cherryphilip74/ArdPressure_filler/V1_dietro.jpeg

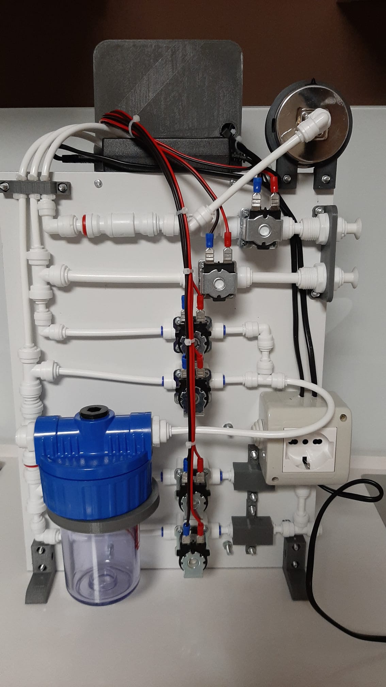
V1_dietro.jpeg
