cherryphilip74/ArdPressure_filler/V3_fronte.jpeg

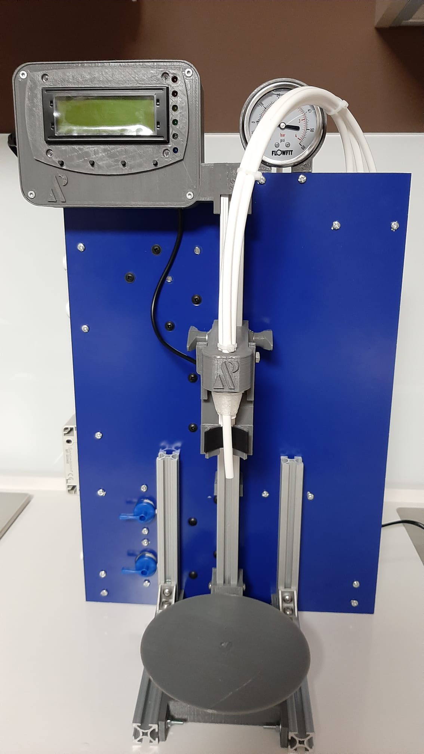
V3_fronte.jpeg
