cherryphilip74/ArdPressure_filler/README.md

# ArdPressure_filler
Counter bottle pressure filler tool
