cherryphilip74/ArdPressure_filler/ARDPressure_V1_Filler.png

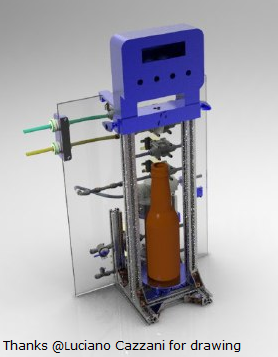
ARDPressure_V1_Filler.png
