cherryphilip74/ArdPressure_filler/ARDPressure_V1_Filler_rear.jpeg

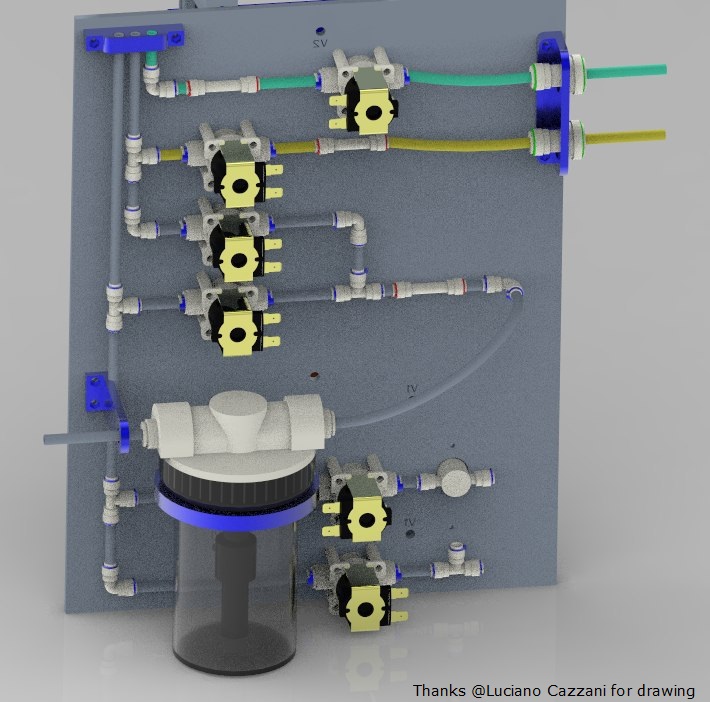
ARDPressure_V1_Filler_rear.jpeg
