cherryphilip74/ArdPressure_filler/Solenoid_Valve_pannel.png

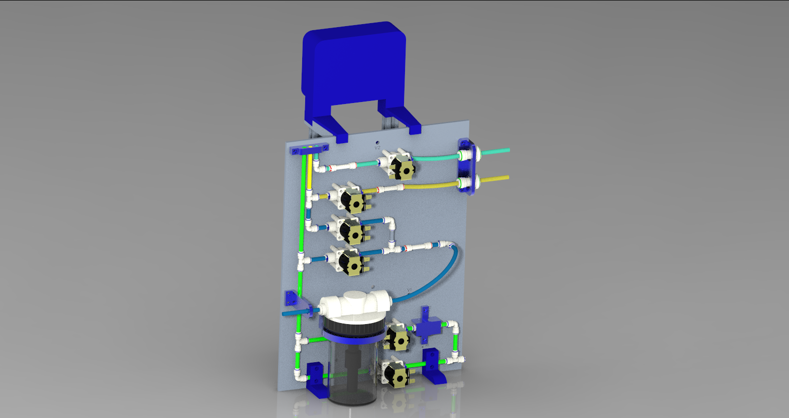
Solenoid_Valve_pannel.png
