cherryphilip74/ArdPressure_filler/V1_fronte.jpeg

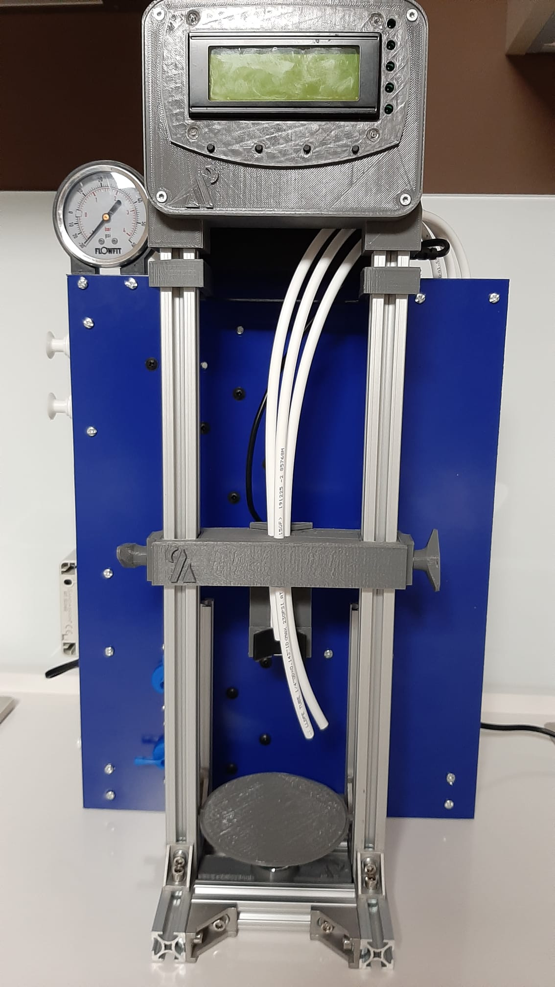
V1_fronte.jpeg
