cherryphilip74/ArdPressure_filler/V3_dietro.jpeg

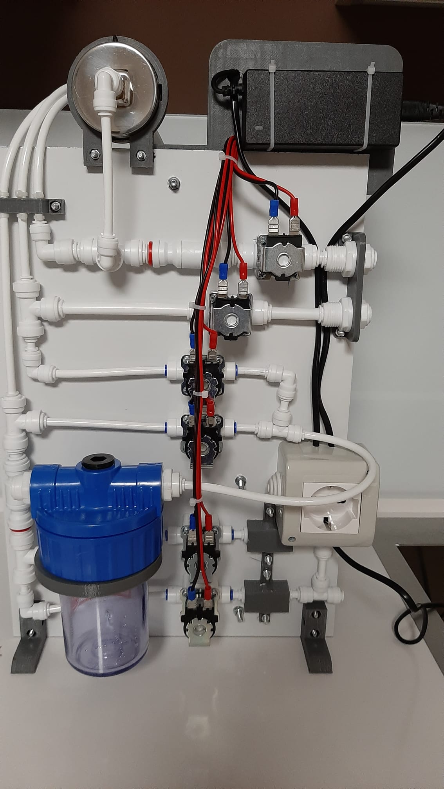
V3_dietro.jpeg
