cherryphilip74/ArdPressure_filler/LEG_EV_PANNEL_SUPPORT_V1.stl

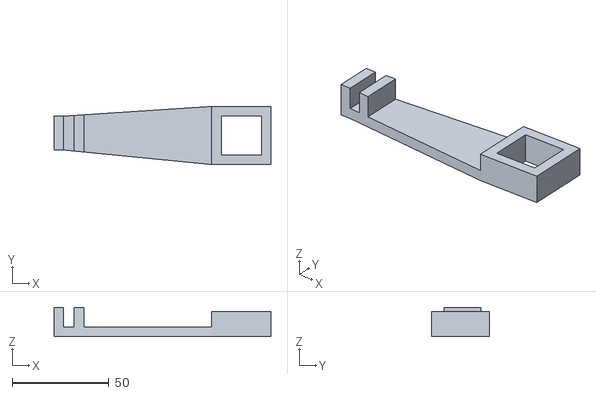
[picture p9: CAD file, 2020-04-16, last stored version]
LEG_EV_PANNEL_SUPPORT_V1.stl
112.0 x 30.0 x 15.0
