cherryphilip74/ArdPressure_filler/M5_BUTTERFLY_V1.stl

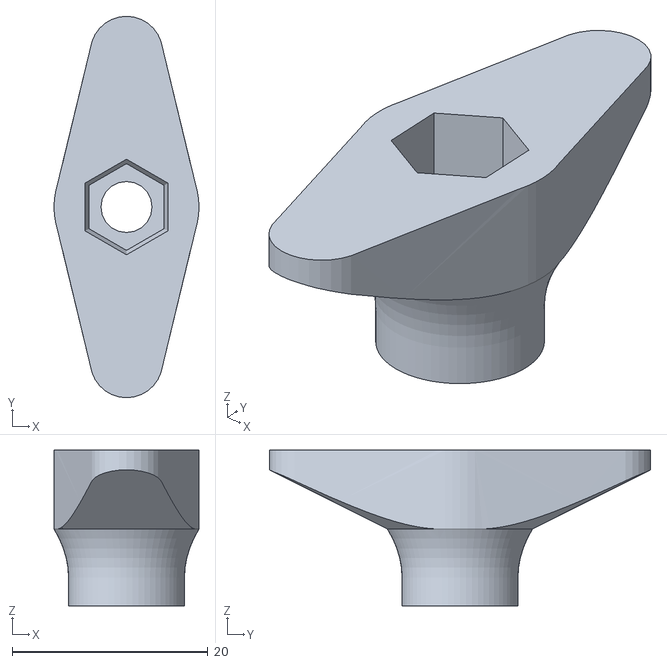
[picture p10: CAD file, 2020-04-16, last stored version]
M5_BUTTERFLY_V1.stl
14.8 x 39.0 x 15.9
