cherryphilip74/ArdPressure_filler/BOTTLE_BASE_V1.stl

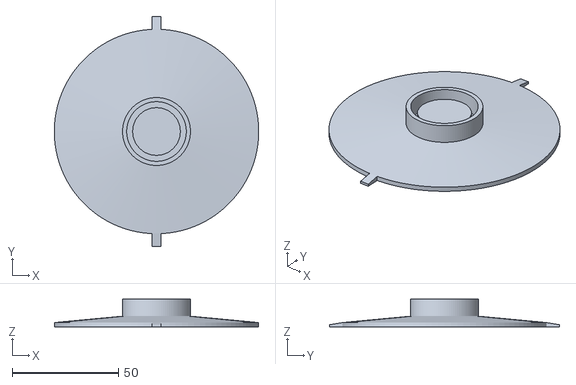
[picture p11: CAD file, 2020-04-16, last stored version]
BOTTLE_BASE_V1.stl
96.0 x 108.0 x 13.0
