cherryphilip74/ArdPressure_filler/SPRING_SUPPORT_V1.stl

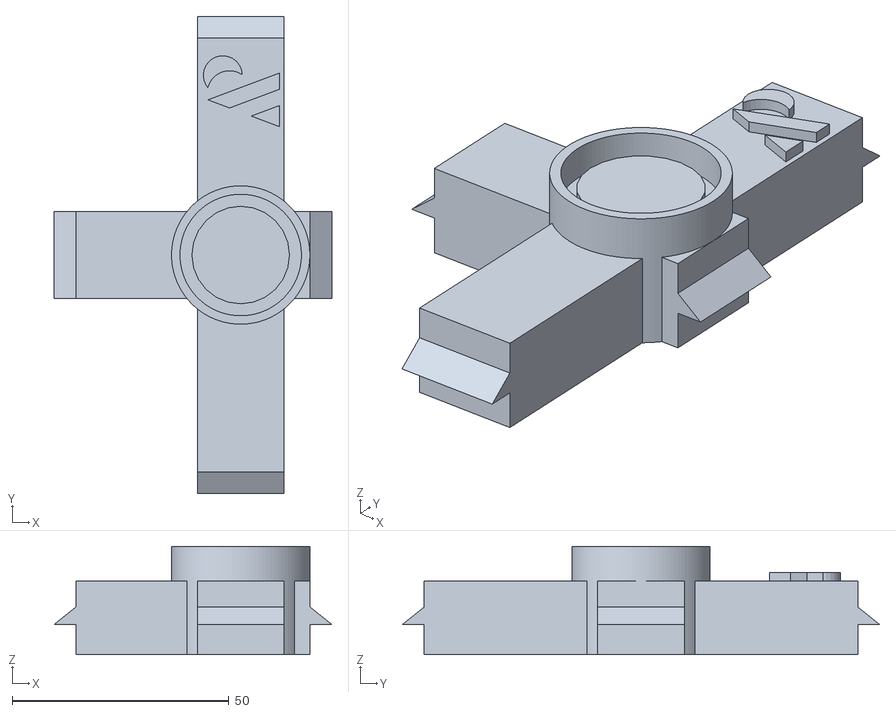
[picture p12: CAD file, 2020-04-16, last stored version]
SPRING_SUPPORT_V1.stl
64.0 x 110.0 x 25.0
