cherryphilip74/ArdPressure_filler/BULKHEAD_SUPPORT_V1.stl

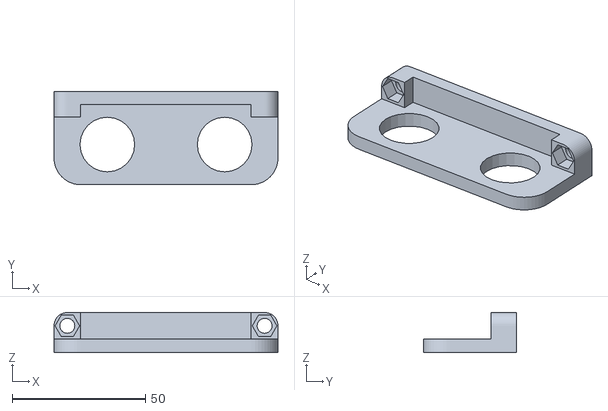
[picture p13: CAD file, 2020-04-16, last stored version]
BULKHEAD_SUPPORT_V1.stl
84.0 x 35.0 x 15.0
