cherryphilip74/ArdPressure_filler/TAP_COVER_V1.stl

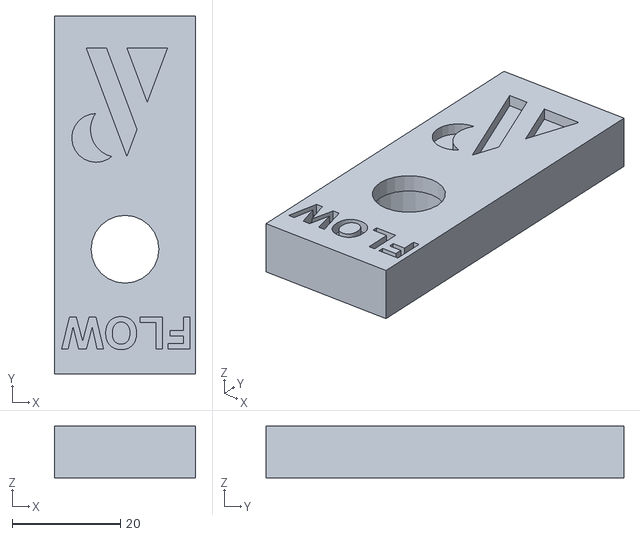
[picture p14: CAD file, 2020-04-16, last stored version]
TAP_COVER_V1.stl
26.0 x 66.0 x 9.50
