cherryphilip74/ArdPressure_filler/HEAD_3_HOLES.stl

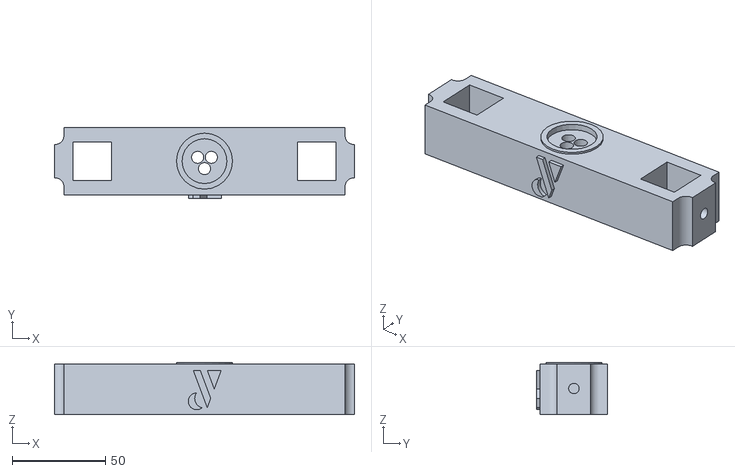
[picture p15: CAD file, 2020-04-16, last stored version]
HEAD_3_HOLES.stl
160.6 x 38.0 x 28.0
