cherryphilip74/ArdPressure_filler/LEVEL_SENSOR_SUPPORT_V1.stl

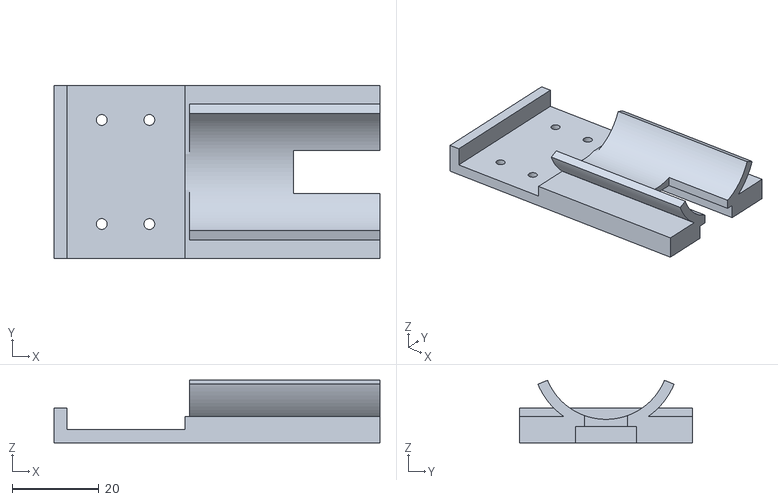
[picture p16: CAD file, 2020-04-16, last stored version]
LEVEL_SENSOR_SUPPORT_V1.stl
75.2 x 40.0 x 14.4
