cherryphilip74/ArdPressure_filler/3_HOLES_HOUSE_V1.stl

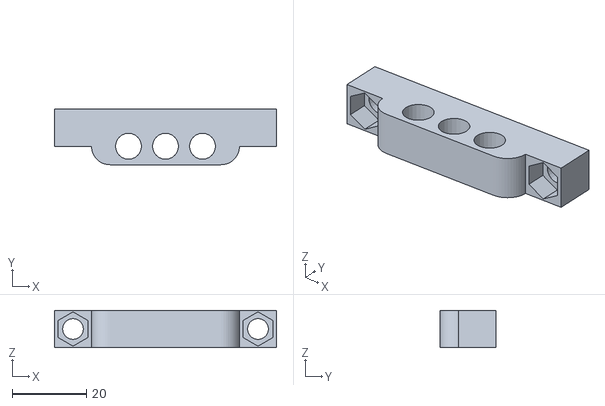
[picture p17: CAD file, 2020-04-16, last stored version]
3_HOLES_HOUSE_V1.stl
60.0 x 15.0 x 10.0
