cherryphilip74/ArdPressure_filler/SUPPORTO_VAC.stl

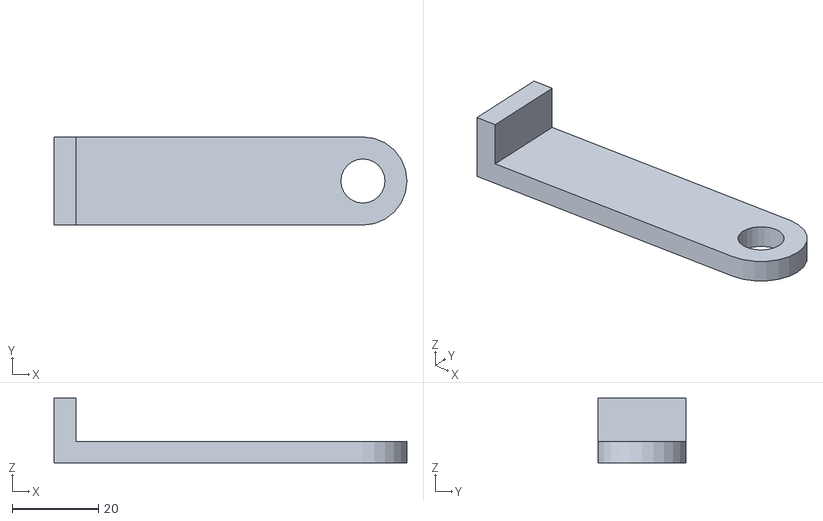
[picture p18: CAD file, 2020-04-16, last stored version]
SUPPORTO_VAC.stl
81.9 x 20.5 x 15.0
