cherryphilip74/ArdPressure_filler/CASE_V1.stl

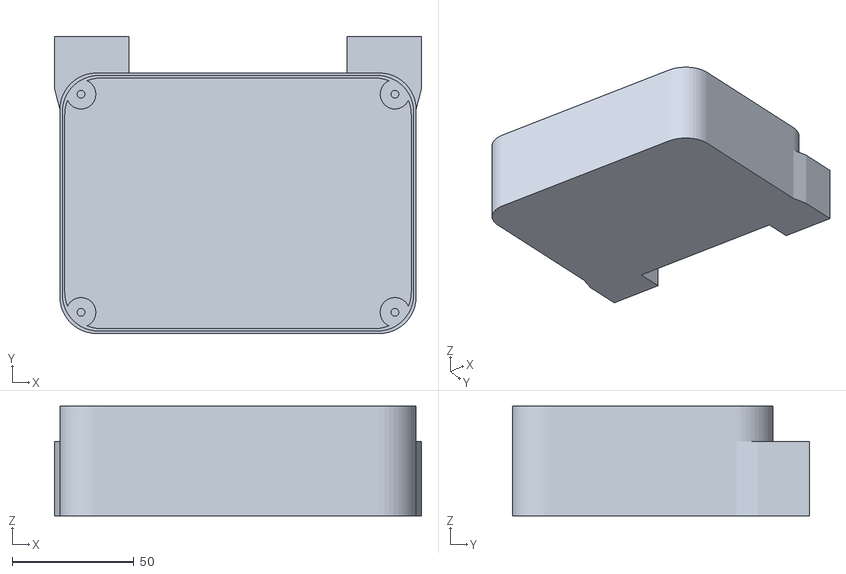
[picture p19: CAD file, 2020-04-16, last stored version]
CASE_V1.stl
150.6 x 121.9 x 45.0
