cherryphilip74/ArdPressure_filler/TANK_SUPPORT.stl

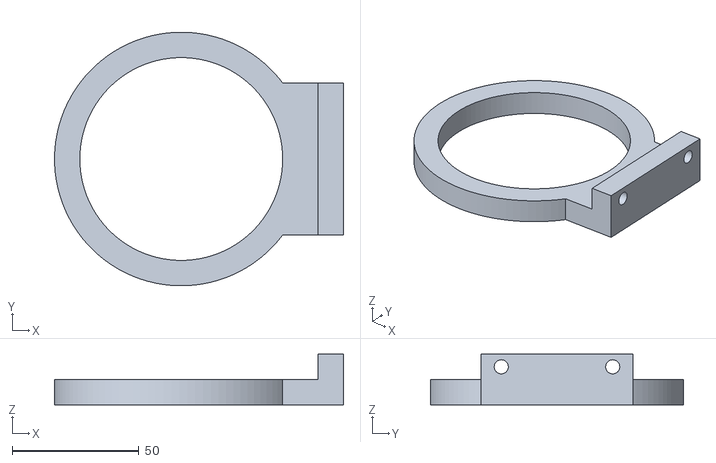
[picture p20: CAD file, 2020-04-16, last stored version]
TANK_SUPPORT.stl
114.0 x 100.0 x 20.0
