cherryphilip74/ArdPressure_filler/(list of files, cad)

Other CAD files:
holes_CNC.dwg
