cherryphilip74/ArdPressure_filler/ASSEMBLY FOR METAL FRAME ARDPRESSURE FILLER KIT.pdf

### ARD PRESSURE (ASSEMBLY MANUAL V1 MODEL)

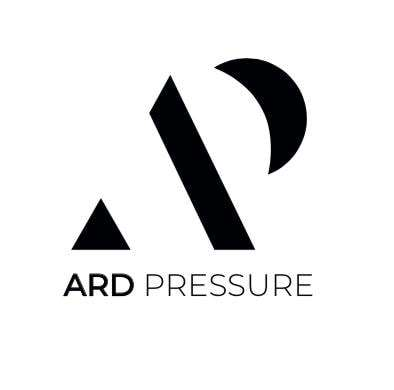
[picture p21: figure]

# ASSEMBLY FOR METAL FRAME ARDPRESSURE FILLER KIT

TABLE OF CONTENTS

### 1. Assembly of the lower chassis 2. Assembly the vertical structure 3. Install the head filler 4. Assembly the solenoide’s pannel 5. Install the solenoide valves 6. Install pipe net 7. Install the case 8. Assemble the ArdPressure and wire connections 9. Fixed power supply

ArdPressure filler, ArdPressure firmware and ArdPressure logo …….

When you use the filler, meet some problems, please contact us.

Technical support telegram ArdPressure:

Please visit the Facebook group, link as follow:

https://www.facebook.com/ArdPressure/

The assembly video as follow:

(video……)

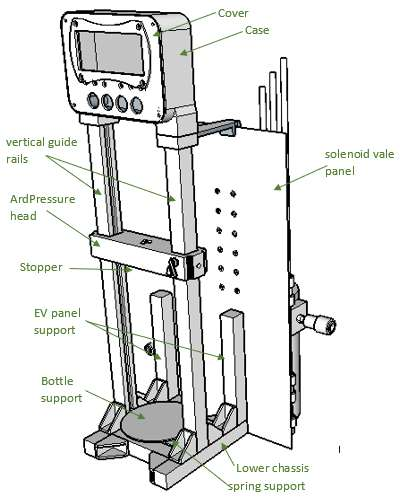
[picture p22: figure]

IN ORDER TO ASSEMBLE, IT’s more convenient to take out the required parts, we have defined each packing slot

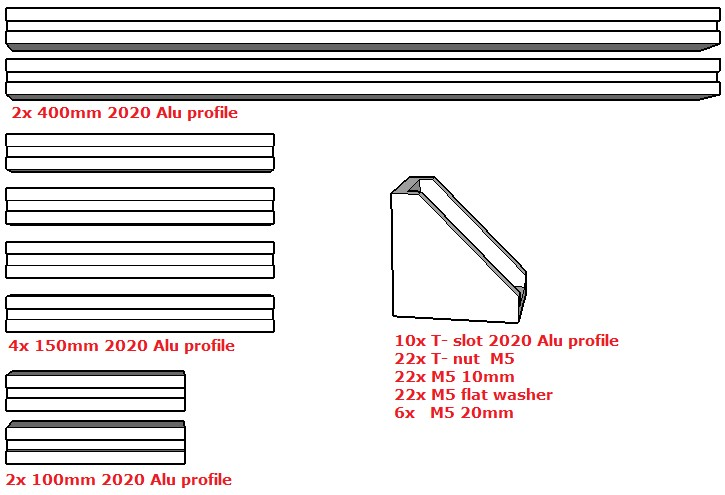
[picture p23: figure]
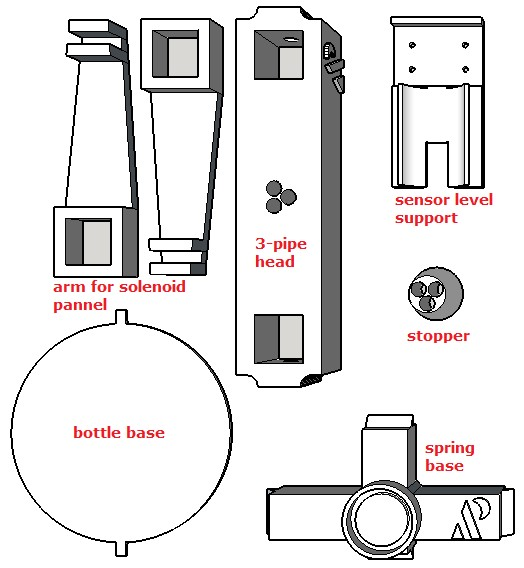
[picture p24: figure]
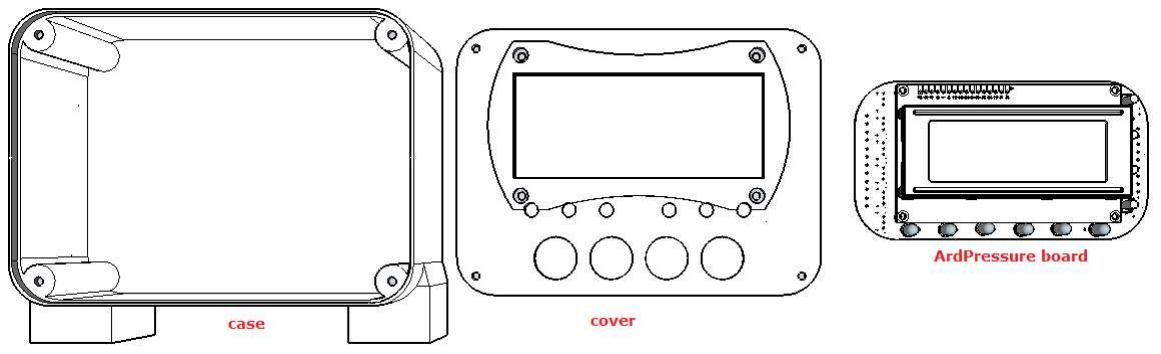
[picture p25: figure]

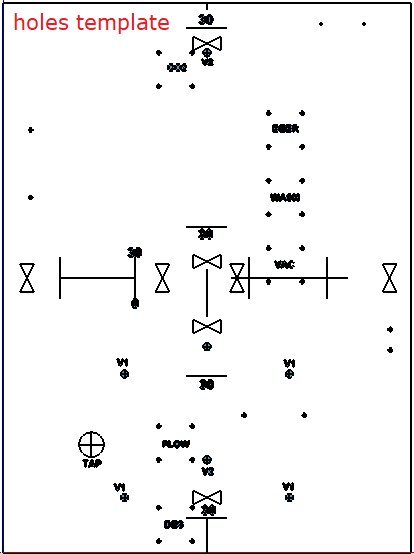
[picture p26: figure]

Other parts:

1x power supply (12v or 24V)

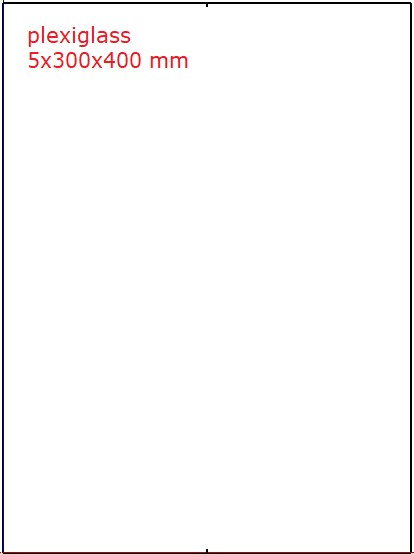
[picture p27: figure]

6x solenoid valve OD ¼ for reverse osmosis water systems (12v or 24v)

6X Elbow Pipe Fittings od ¼ for reverse osmosis water systems

5x Tee Pipe Coupling Connector OD ¼ for reverse osmosis water systems

1x Water Flow Control Valve OD ¼ for reverse osmosis water systems

3x check valve OD ¼ for reverse osmosis water systems

2x Straight Bulkhead Connector OD ¼ internal and OD 3/8 external for reverse osmosis water system

1x Straight Connector 1/2 male Thread OD 1/4 for Plastic Pipe for reverse osmosis water system

1x Straight Connector 1/2 male Thread OD 3/8 for Plastic Pipe for reverse osmosis water system

1x Non-Contact Liquid Level Sensor XKC-Y26-NPN type

1x ssr 10 ampere

LET’S GO……

## 1. Assembly of the lower chassis

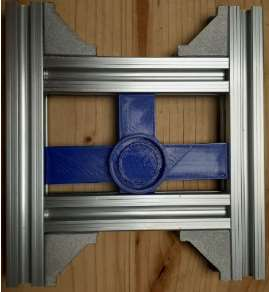
[picture p28: figure]

This is the structure that we will assemble

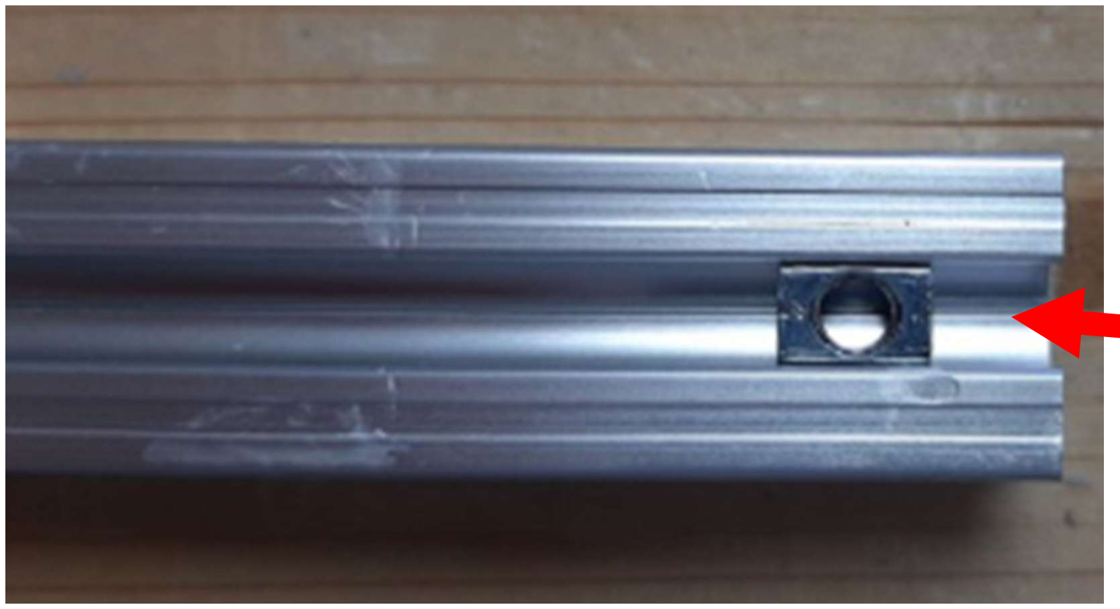
[picture p29: figure]

### INSERT M5 T-NUT

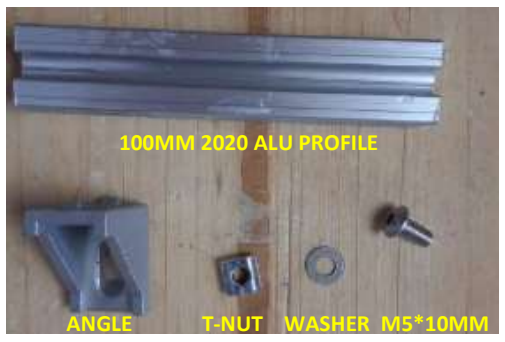
[picture p30: figure]
100MM 2020 ALU PROFILE; ANGLE; T-NUT WASHER M5*10MM
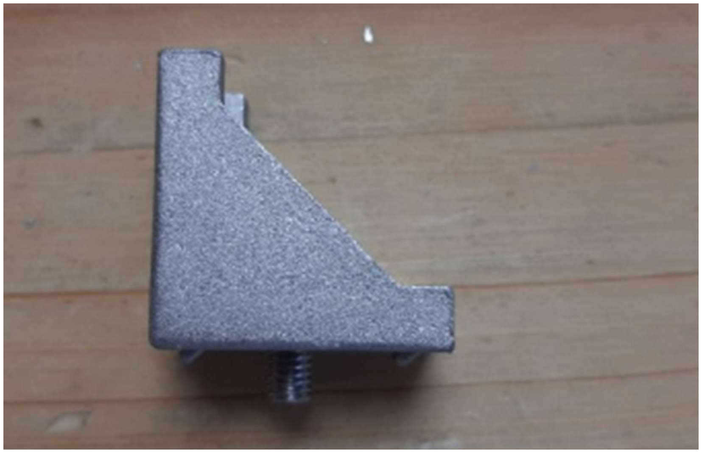
[picture p31: figure]
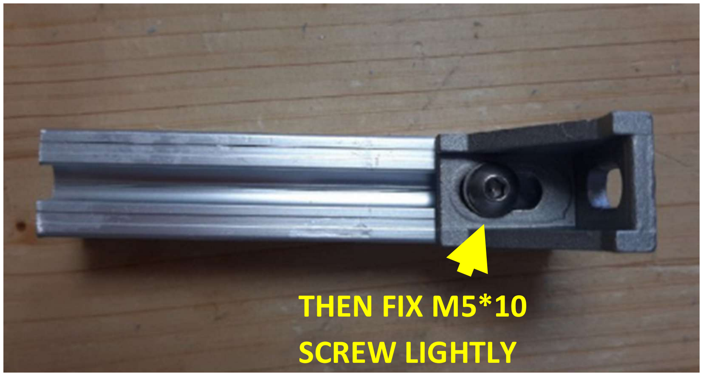
[picture p32: figure]
THEN FIX M5*10 SCREW LIGHTLY

Do the same for the second side

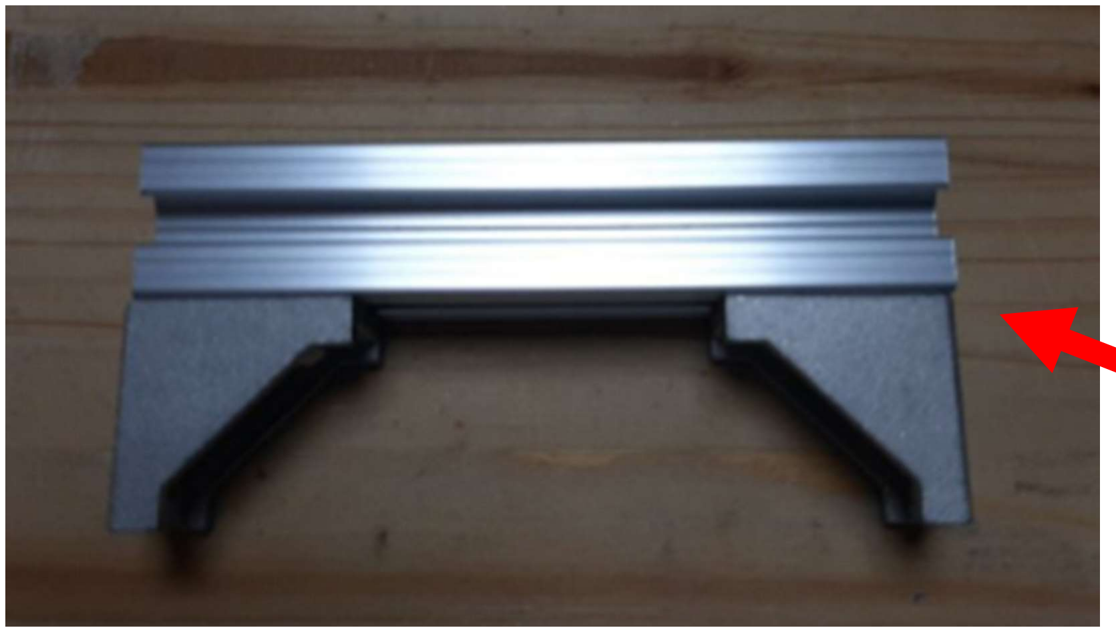
[picture p33: figure]

Repeat for second 100MM arm

### KEEP ALIGN

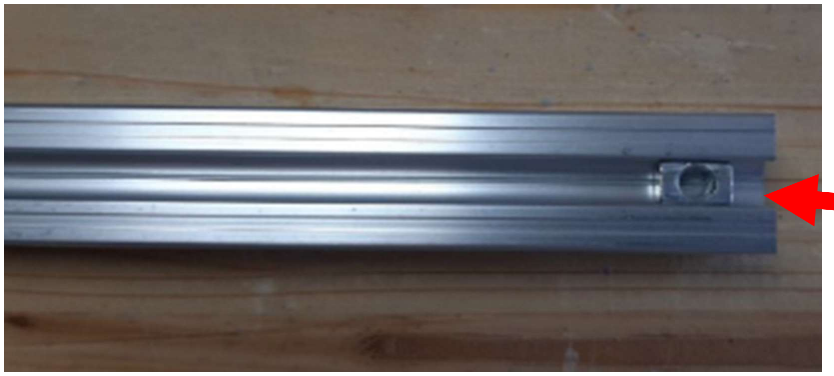
[picture p34: figure]

### INSERT M5 T-NUT

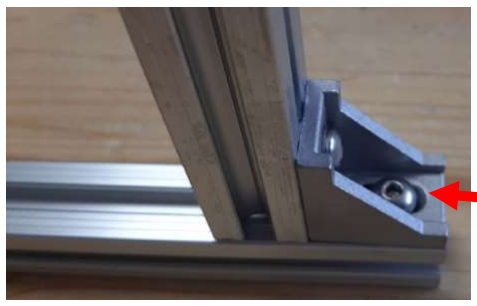
[picture p35: figure]

### PUSH AND KEEP ALIGN

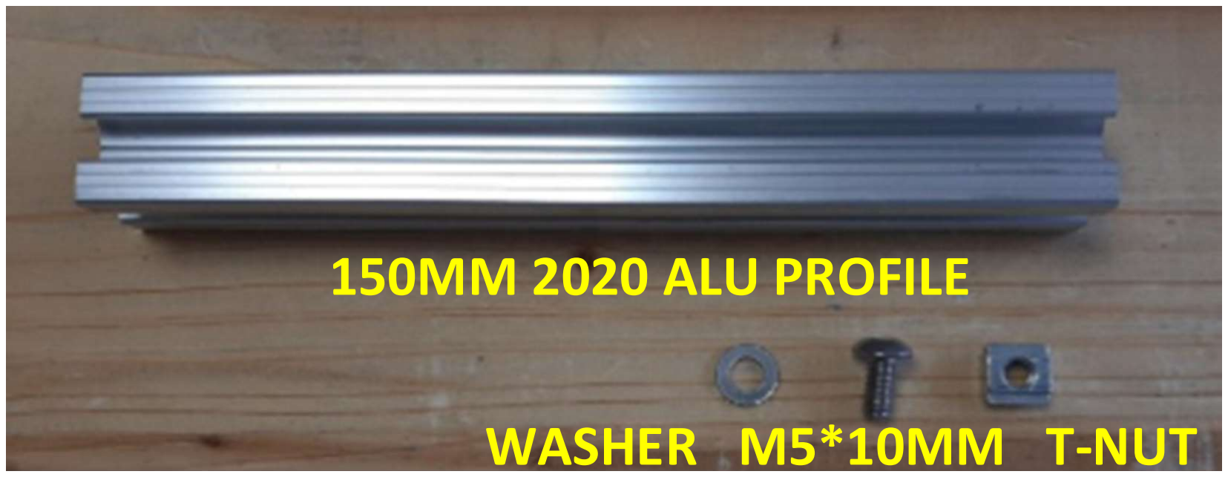
[picture p36: figure]
150MM 2020 ALU PROFILE; WASHER M5*10MM T-NUT
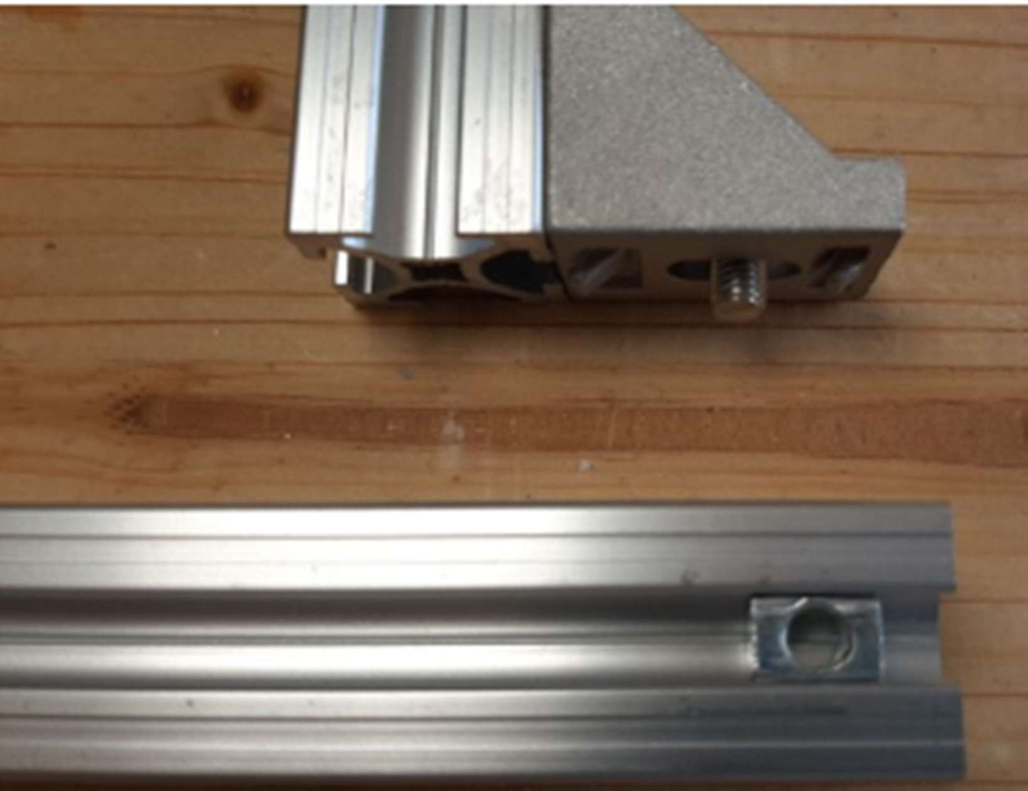
[picture p37: figure]

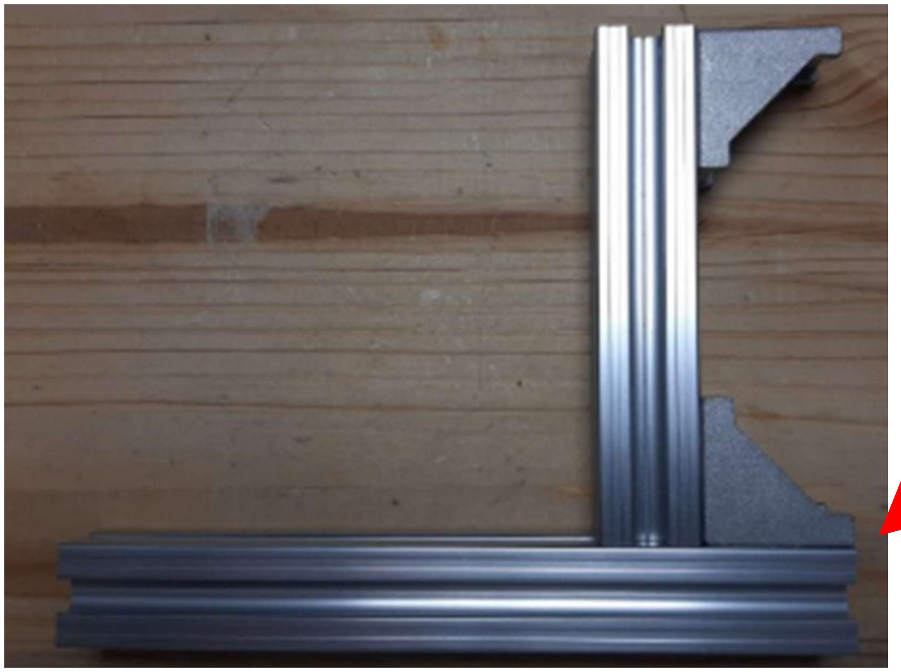
[picture p38: figure]

INSTALL THE OTHER SAME PART IN THE SAME WAY

### KEEP ALIGN

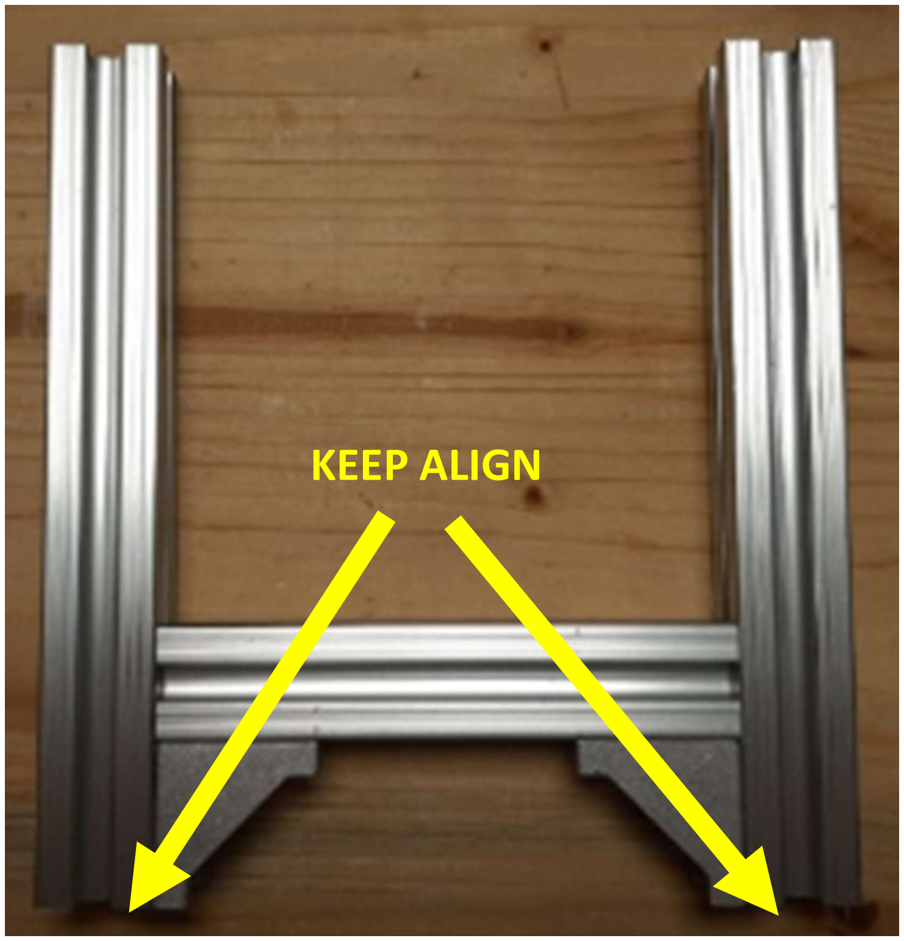
[picture p39: figure]
KEEP ALIGN
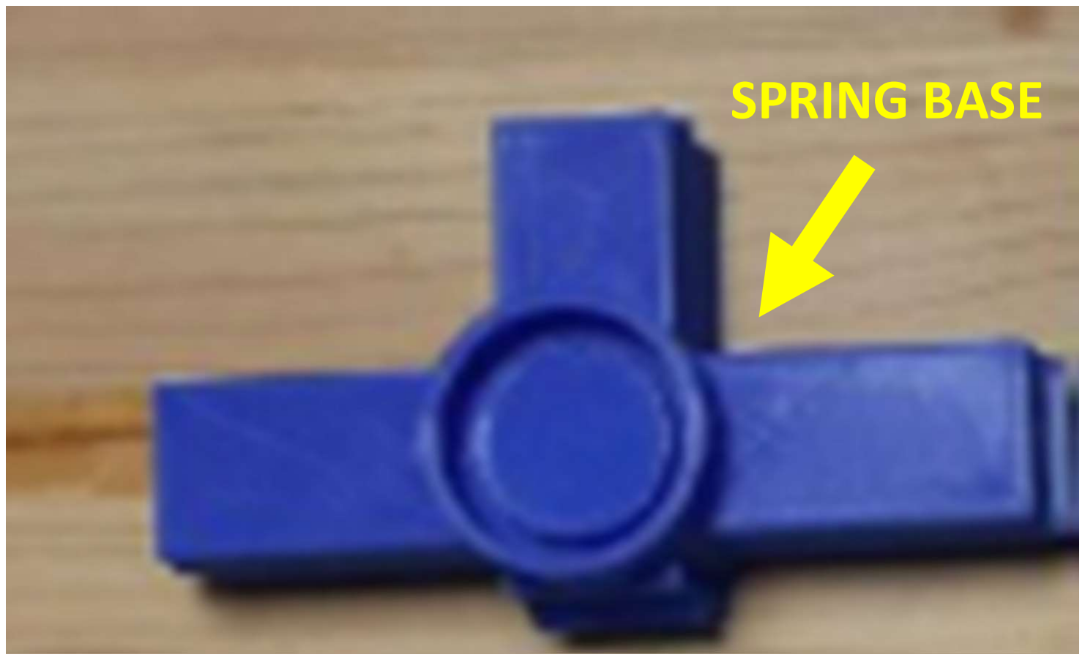
[picture p40: figure]
SPRING BASE

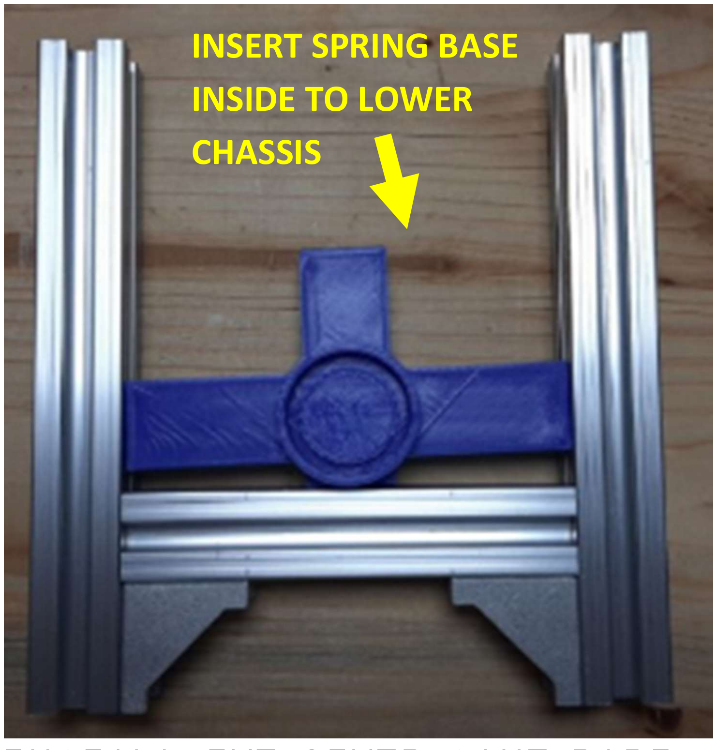
[picture p41: figure]
INSERT SPRING BASE INSIDE TO LOWER CHASSIS

INSTALL THE OTHER SAME PART 100MM ARM IN THE SAME WAY

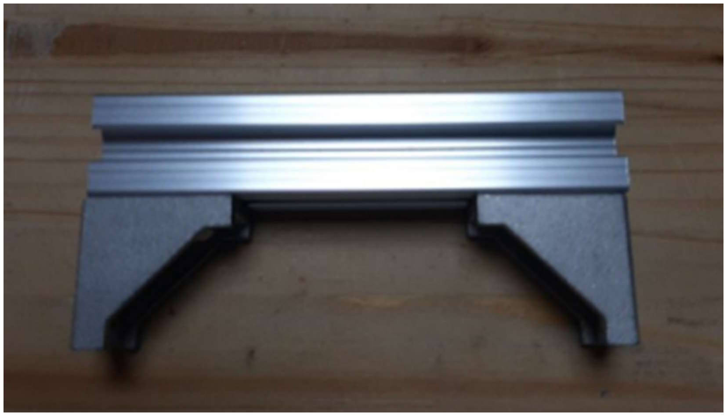
[picture p42: figure]

## 2. Assembly the vertical structure

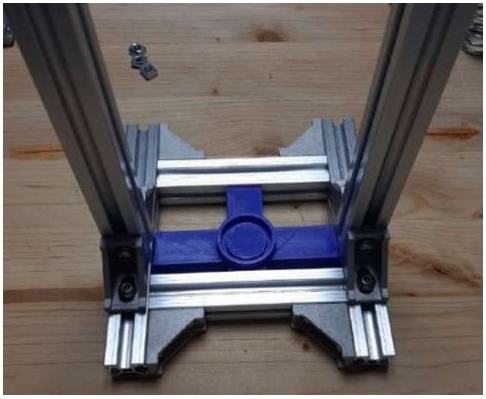
[picture p43: figure]

This is the structure that we will assemble

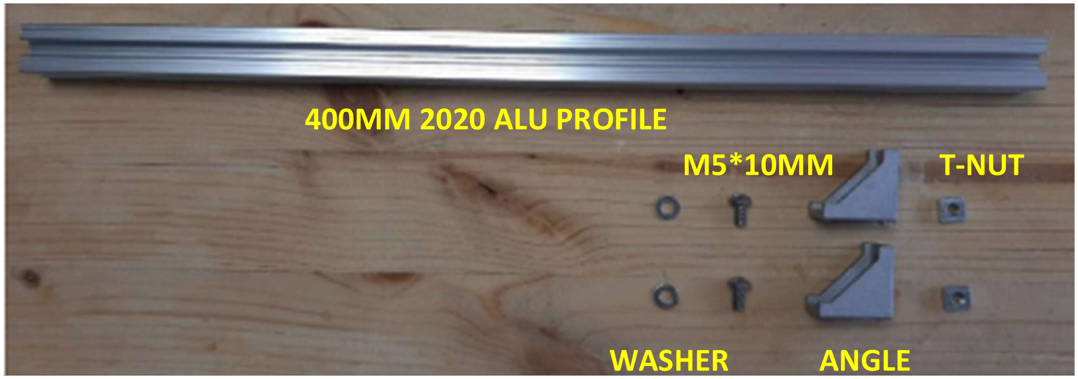
[picture p44: figure]
400MM 2020 ALU PROFILE; T-NUT; WASHER; ANGLE

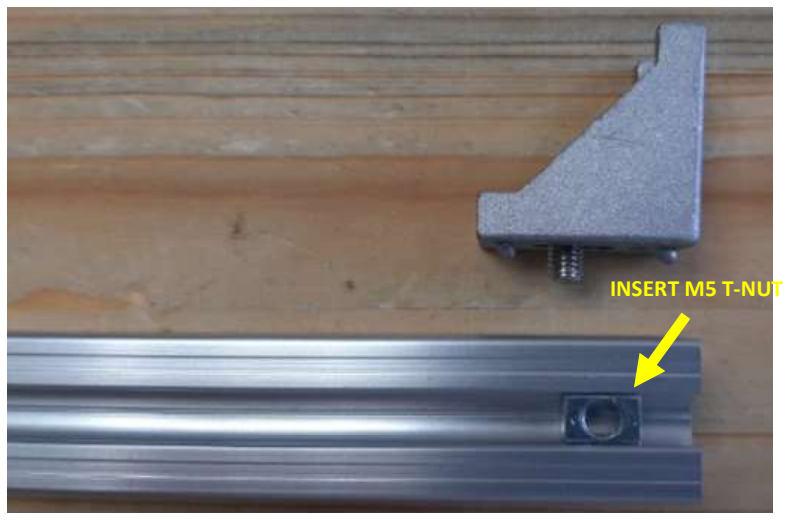
[picture p45: figure]
INSERT M5 T-NUT

INSTAL THE second support angle behind the first

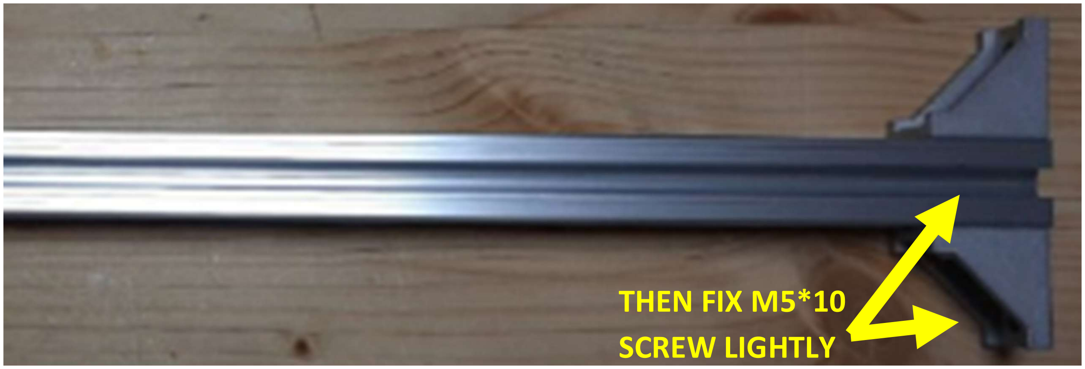
[picture p46: figure]
THEN FIX M5*10 SCREW LIGHTLY

Assemble the same part (400mm alu profile)IN THE SAME WAY

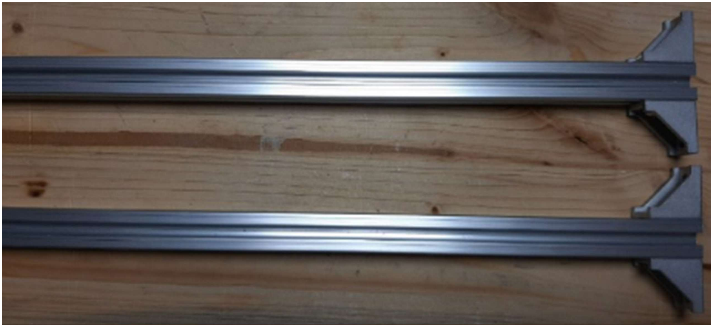
[picture p47: figure]

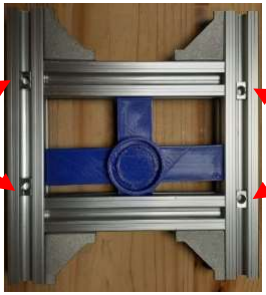
[picture p48: figure]
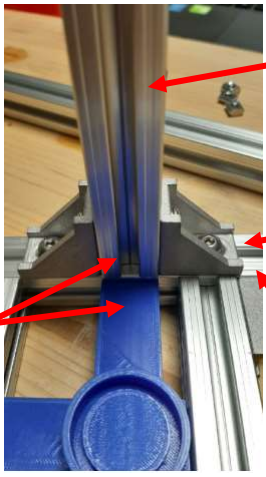
[picture p49: figure]

Assemble the same part (400mm alu profile)IN THE SAME WAY

### INSERT M5 T-NUT

### INSERT M5 T-NUT

### 400MM ALU PROFILE

### 150MM ALU PROFILE

### PUSH AND KEEP ALIGN

### KEEP ALIGN

## 3. Install the head fillER, SPRING AND BOTTLE BASE

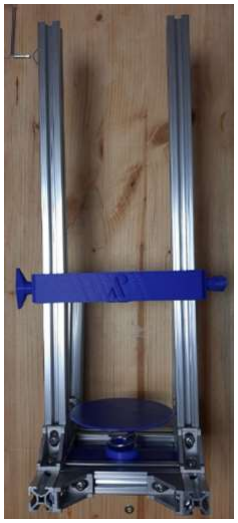
[picture p50: figure]

This is the structure that we will assemble

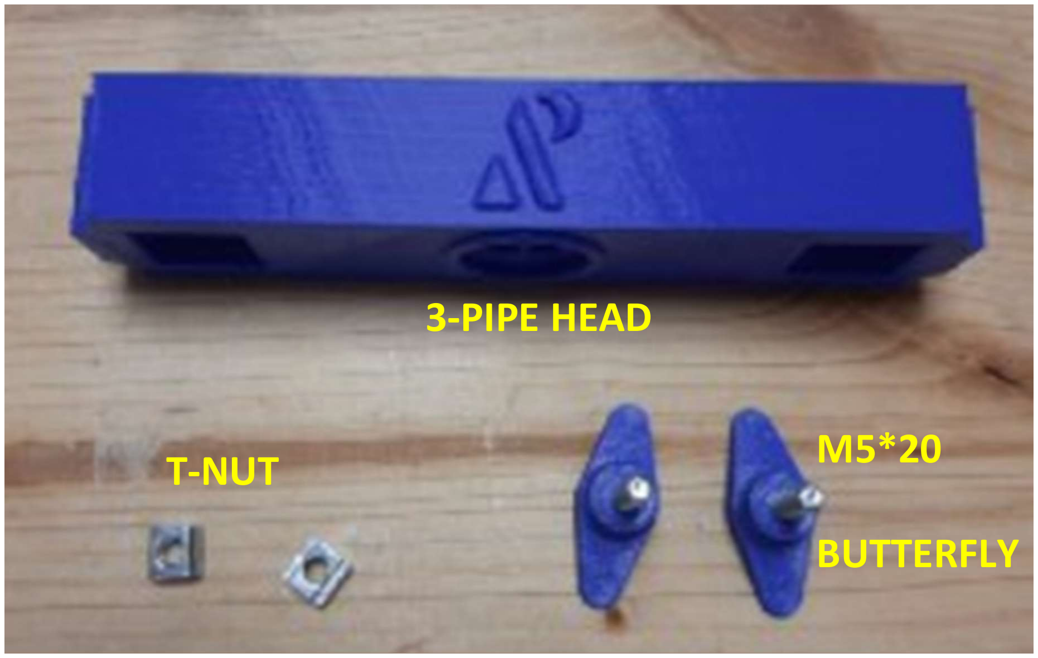
[picture p51: figure]
3-PIPE HEAD; T-NUT; BUTTERFLY
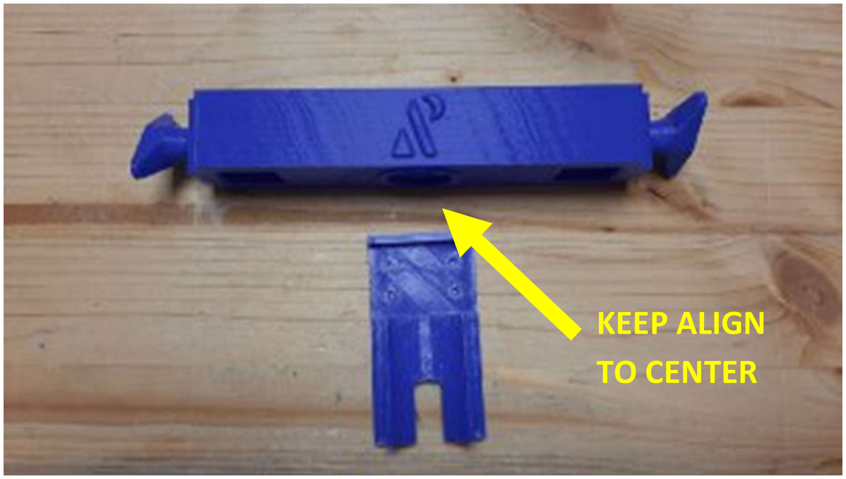
[picture p52: figure]
KEEP ALIGN TO CENTER

INSTALL LEVEL SENSOR SUPPORT

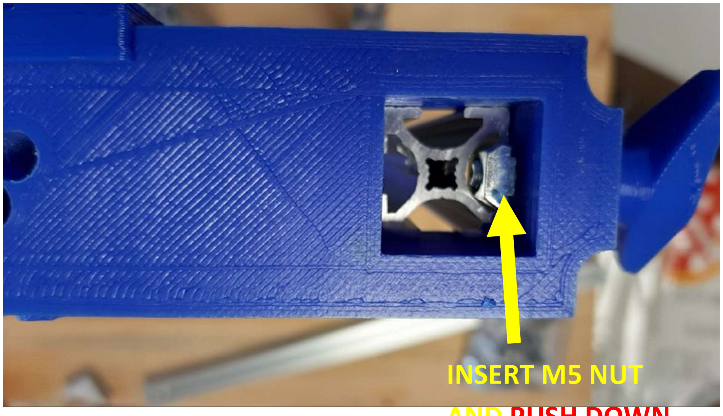
[picture p53: figure]
INSERT M5 NUT
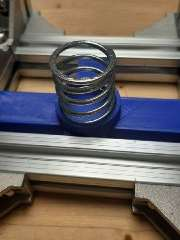
[picture p54: figure]
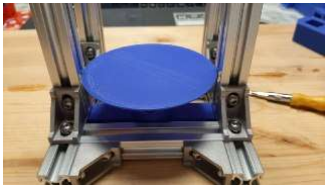
[picture p55: figure]

MOUNT SPRING ON CENTER HOLE AND PUSH DOWN STRONGLY AND THEN PUT THE BOTTLE BASE

### AND PUSH DOWN

## 4. Assembly the solenoid pannel

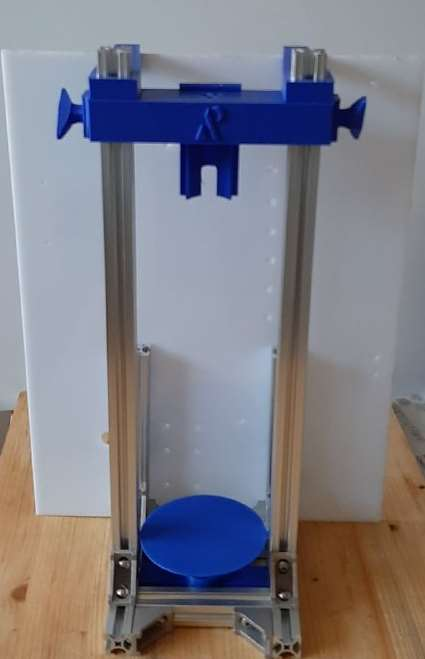
[picture p56: figure]

this is the structure that we will assemble

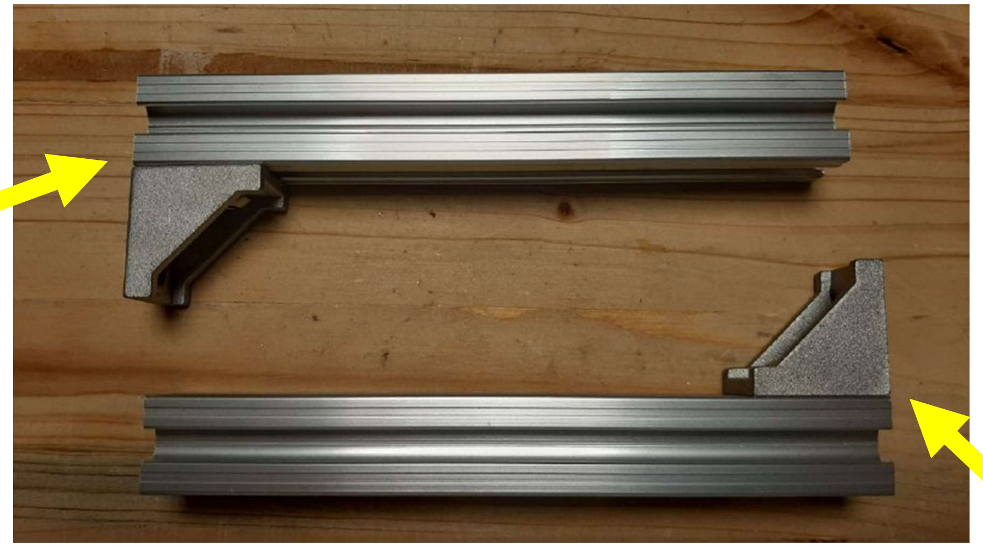
[picture p57: figure]

### KEEP ALIGN

### KEEP ALIGN

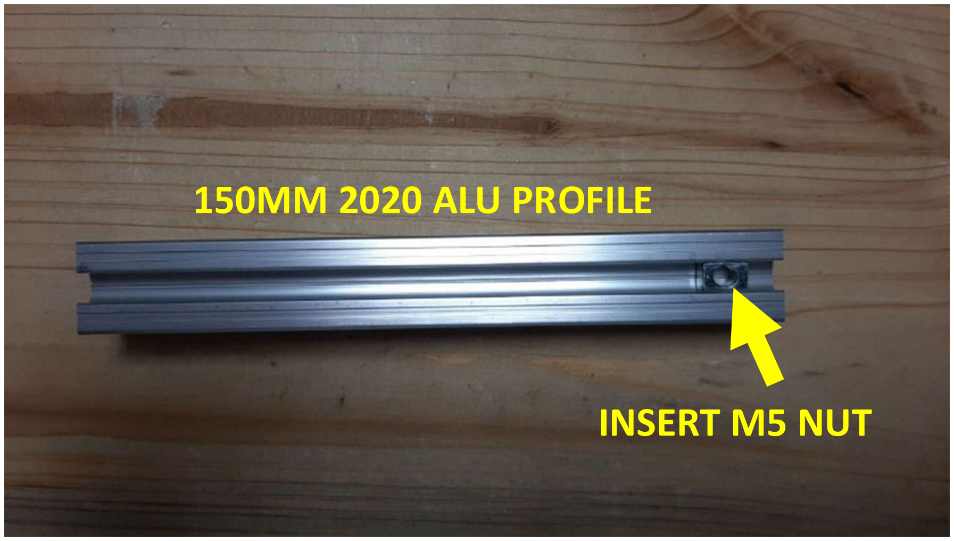
[picture p58: figure]
INSERT M5 NUT; 150MM 2020 ALU PROFILE
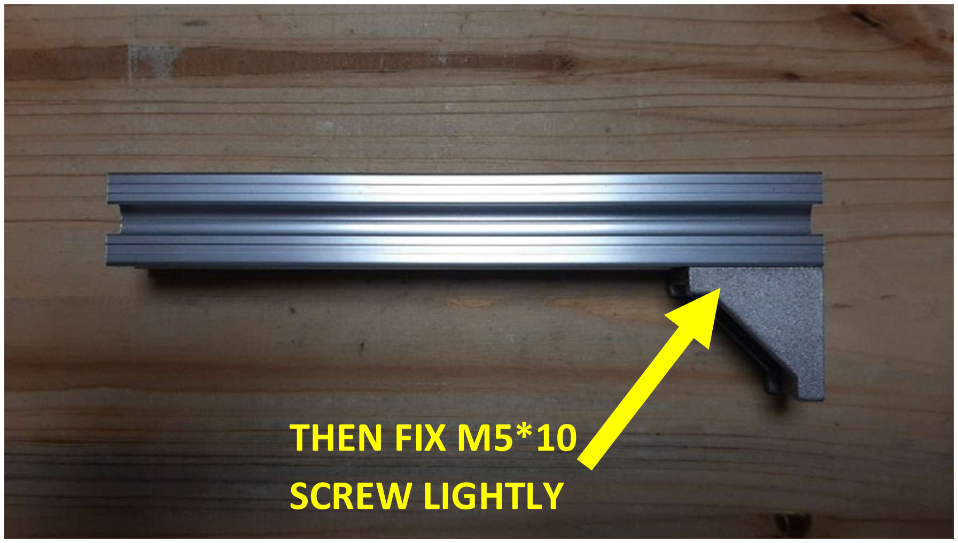
[picture p59: figure]
THEN FIX M5*10 SCREW LIGHTLY
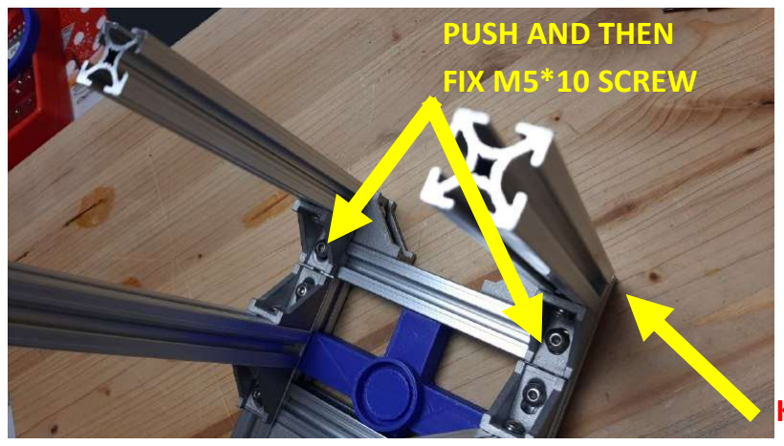
[picture p60: figure]
PUSH AND THEN FIX M5*10 SCREW

### KEEP ALIGN

PRINT THE HOLES TEMPLATE, (please find the template attached to end of this document), CUT EACH SHEET NEAR THE BLACK LINE

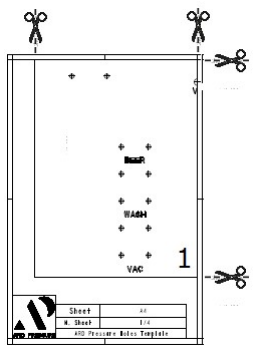
[picture p61: figure]

AND THEN CONNECT THEM BETWEEN THEM ACCORDING TO THE TEMPLATE SHOWN BELOW.

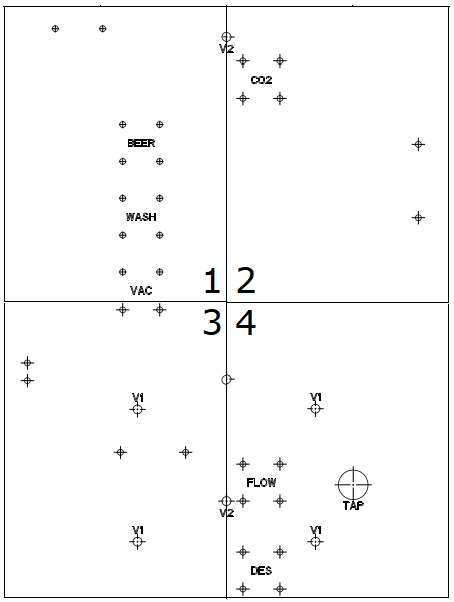
[picture p62: figure]
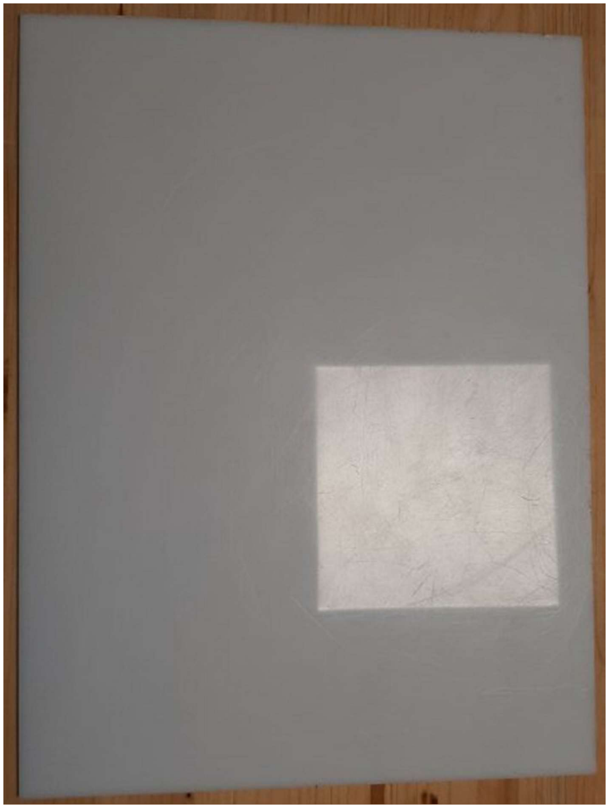
[picture p63: figure]

PLACE THE HOLES TEMPLATE ABOVE THE PLEXIGLASS AND KEEP POSITION WITH ADHESIVE PAPER.

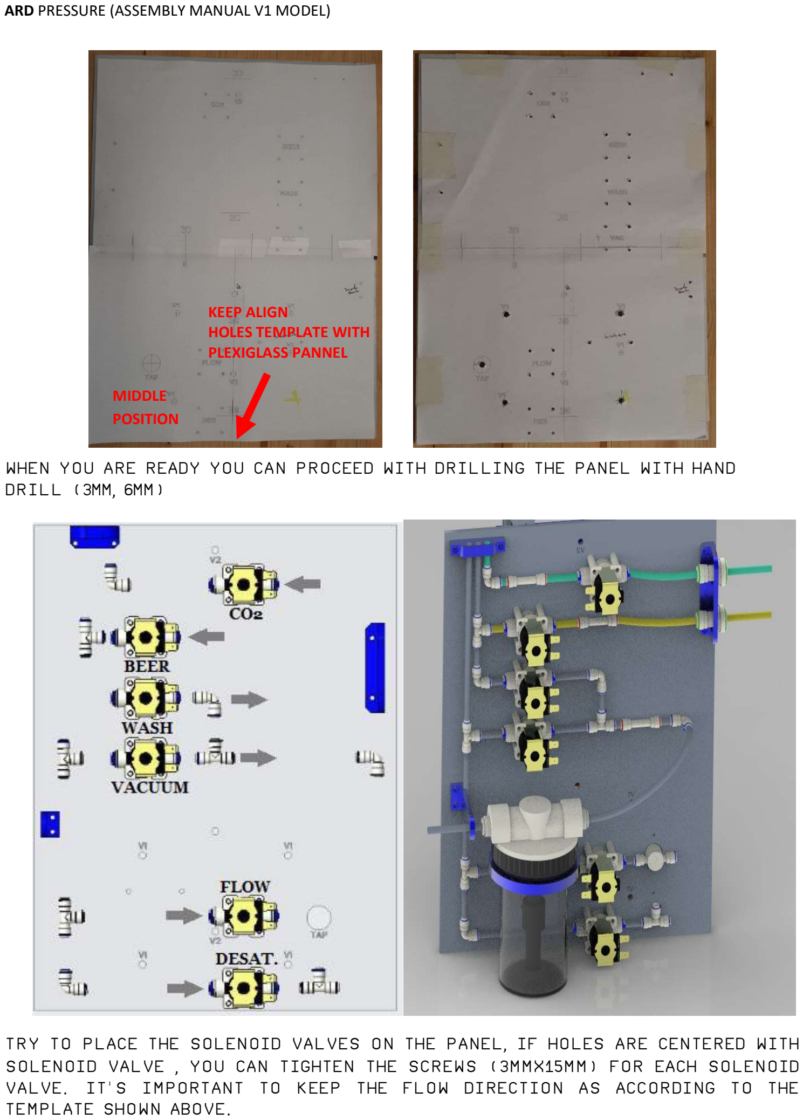
[picture p64: page 19]

WHEN YOU ARE READY YOU CAN PROCEED WITH DRILLING THE PANEL WITH HAND DRILL (3mm, 6mm)

TRY TO PLACE THE SOLENOID VALVES ON THE PANEL, IF HOLES ARE CENTERED WITH SOLENOID VALVE , YOU CAN TIGHTEN THE SCREWS (3MMX15MM) FOR EACH SOLENOID VALVE. IT'S IMPORTANT TO KEEP THE FLOW DIRECTION AS ACCORDING TO THE TEMPLATE SHOWN ABOVE.

### KEEP ALIGN HOLES TEMPLATE WITH PLEXIGLASS PANNEL

### MIDDLE POSITION

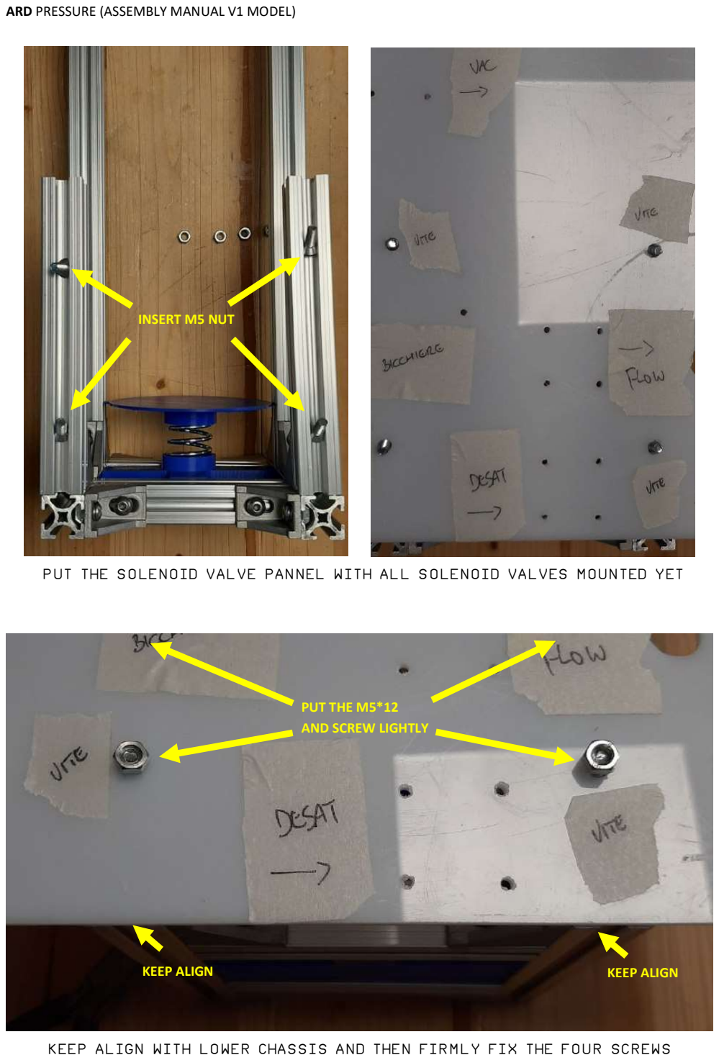
[picture p65: page 20]

PUT THE SOLENOID VALVE PANNEL WITH ALL SOLENOID VALVES MOUNTED YET

KEEP ALIGN WITH LOWER CHASSIS AND THEN FIRMLY FIX THE FOUR SCREWS

### INSERT M5 NUT

### PUT THE M5*12 AND SCREW LIGHTLY

KEEP ALIGN | KEEP ALIGN

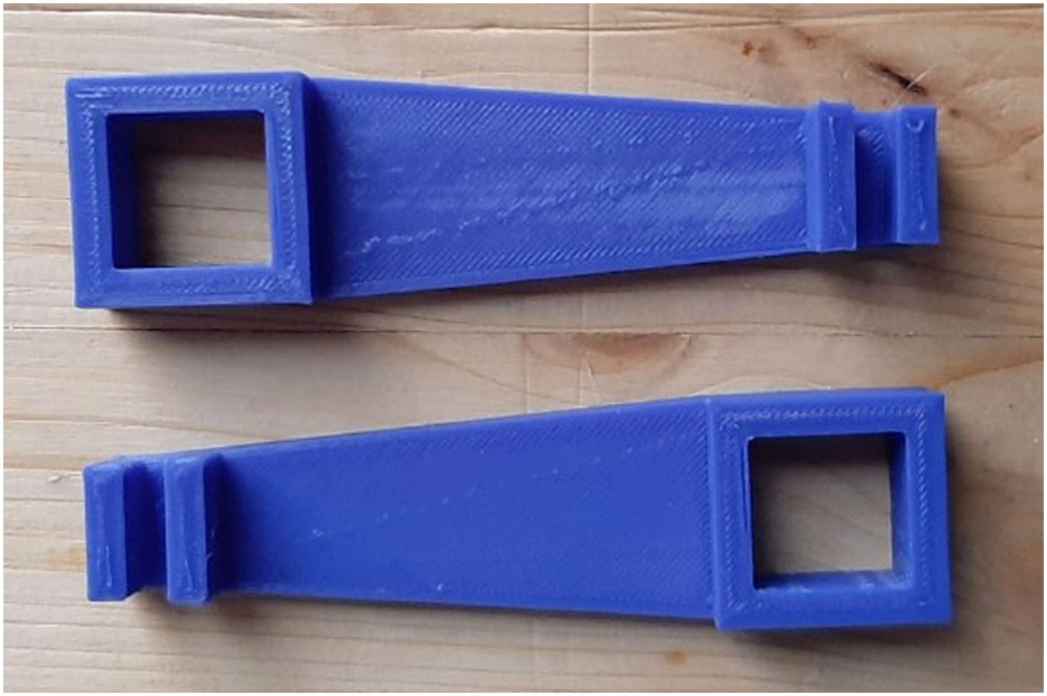
[picture p66: figure]

MOUNT BOTH ARMS ON 400MM ALU PROFILE

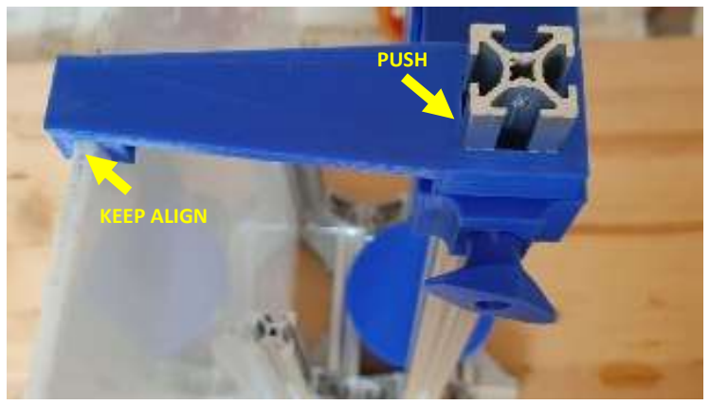
[picture p67: figure]
KEEP ALIGN; PUSH
