cherryphilip74/ArdPressure_filler/ARDPressure_Holes_Template.pdf

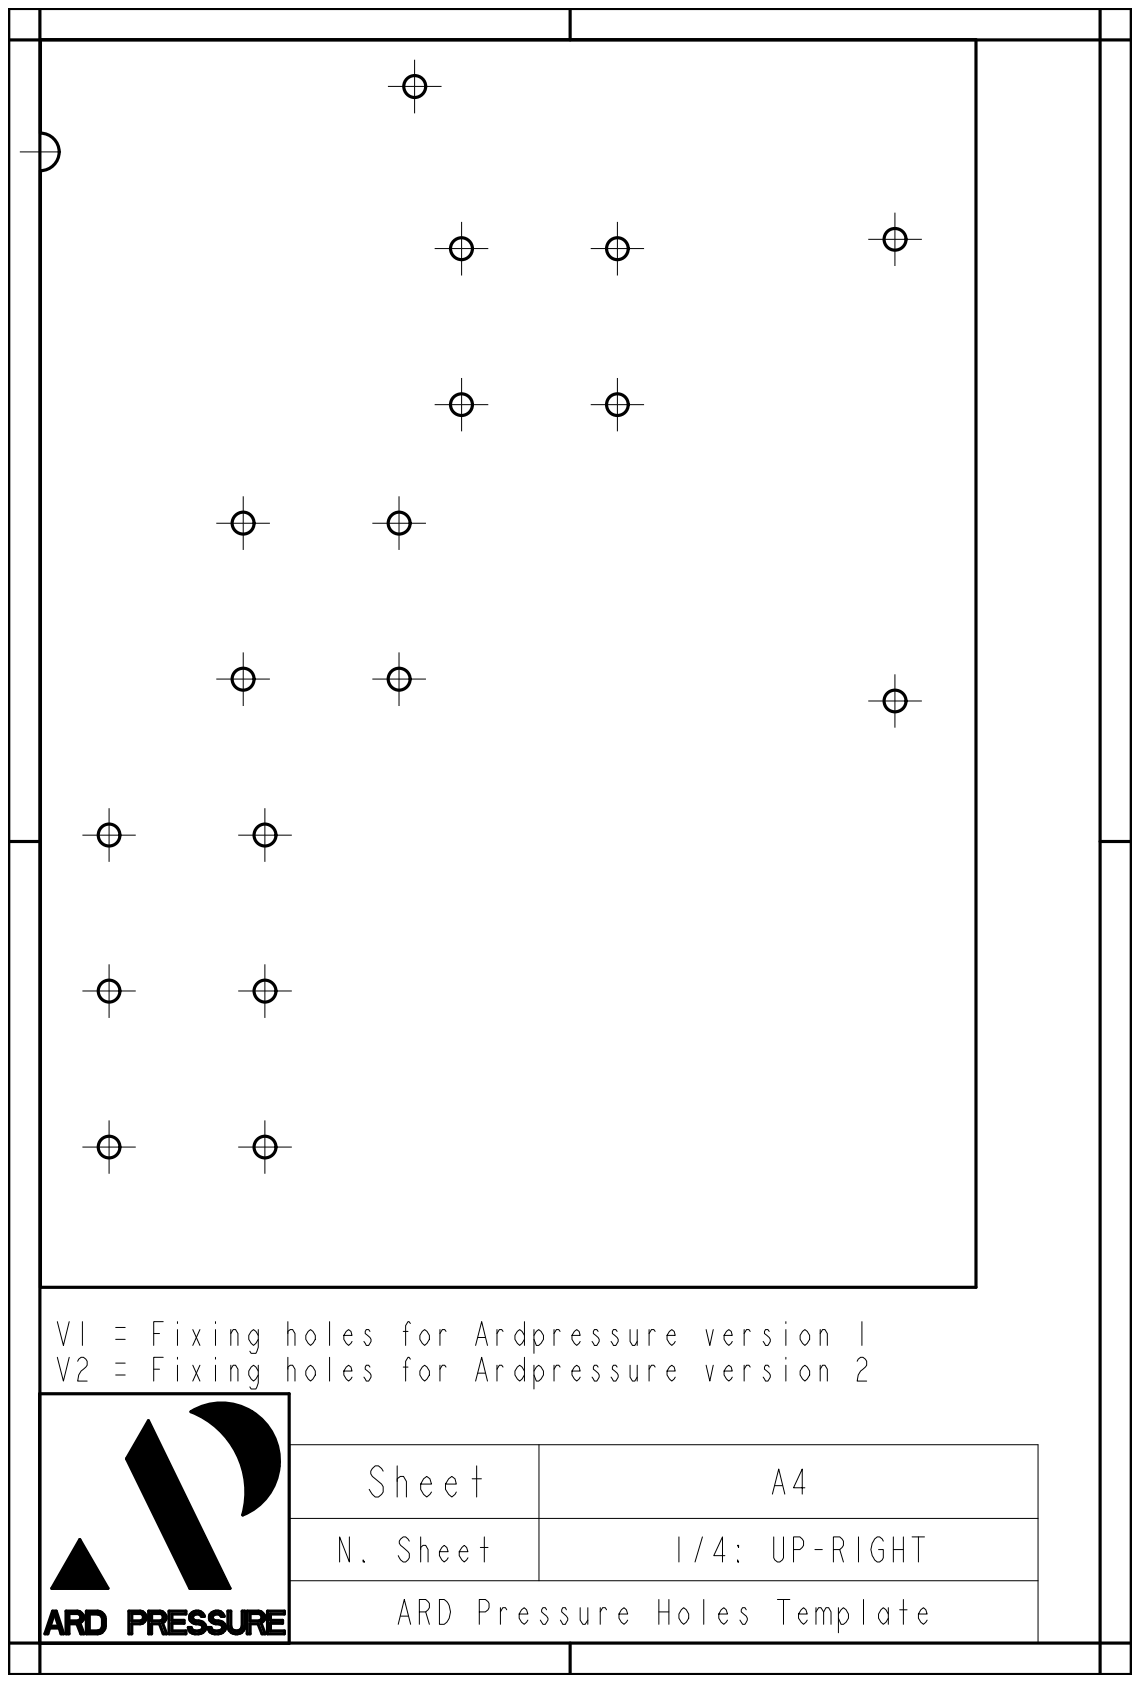
[picture p68: page 1]

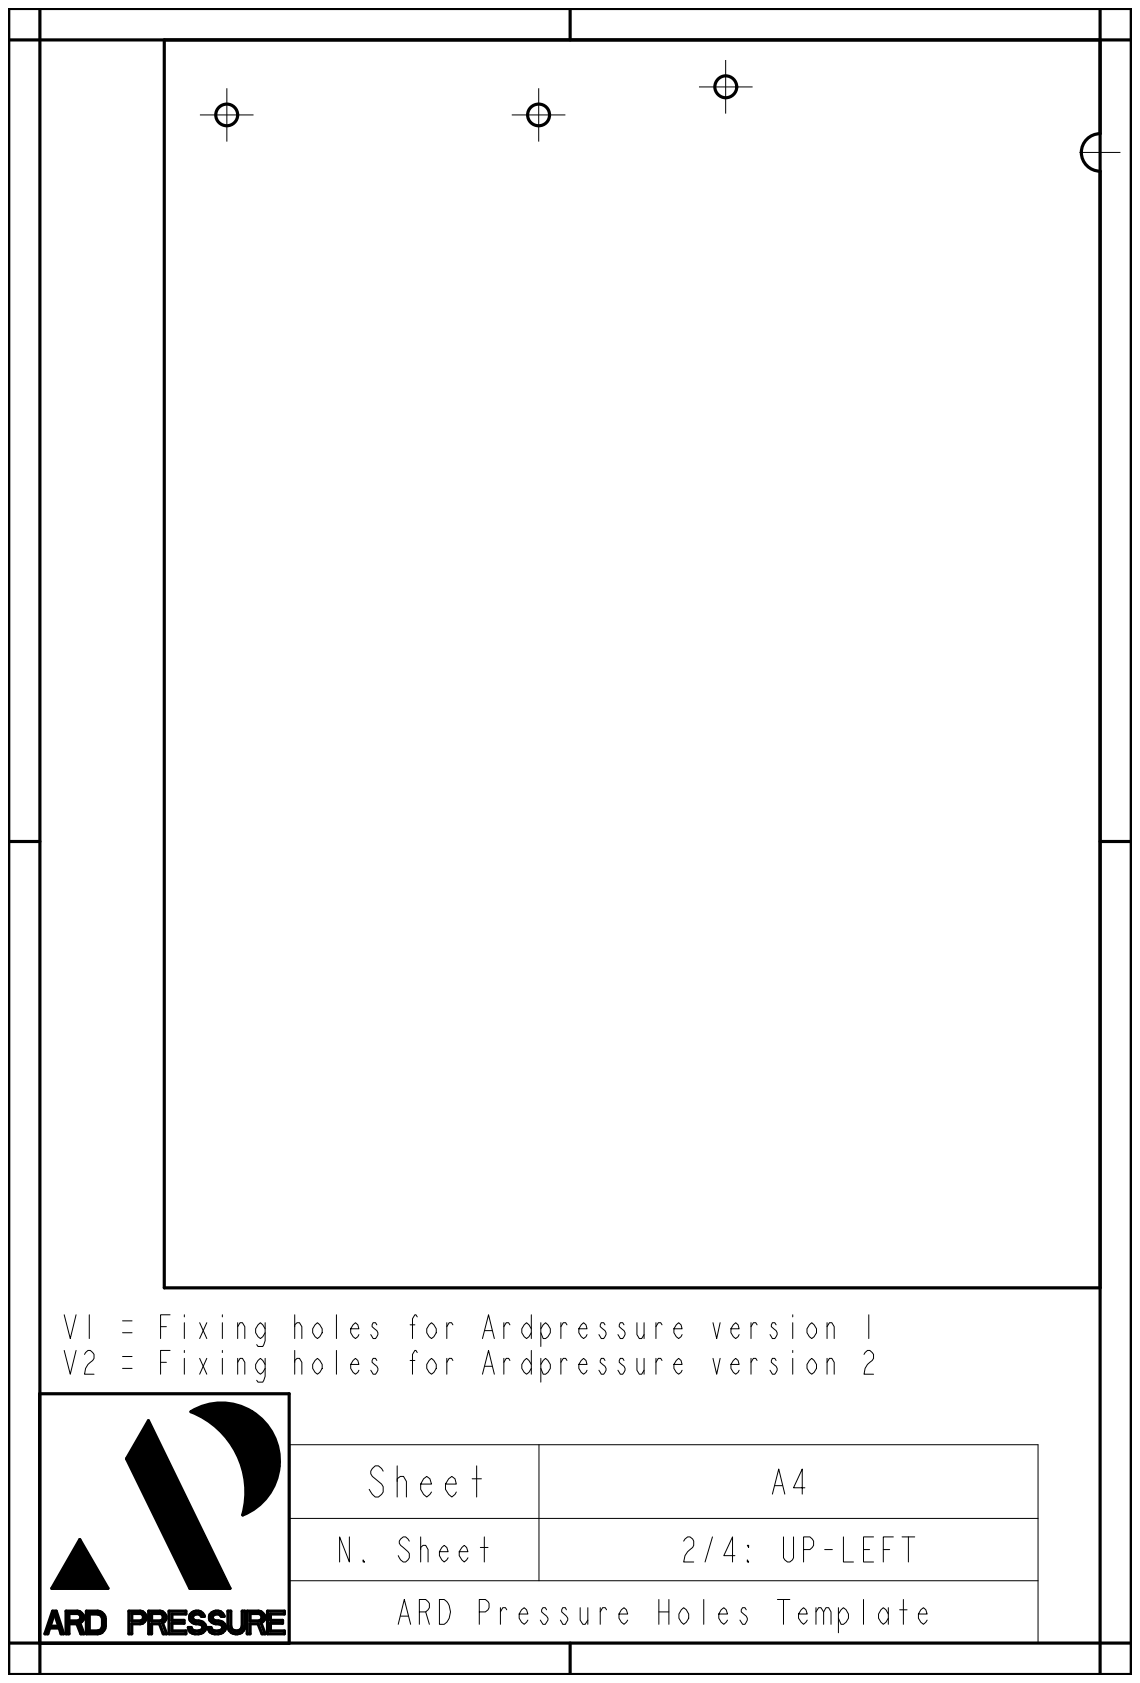
[picture p69: page 2]

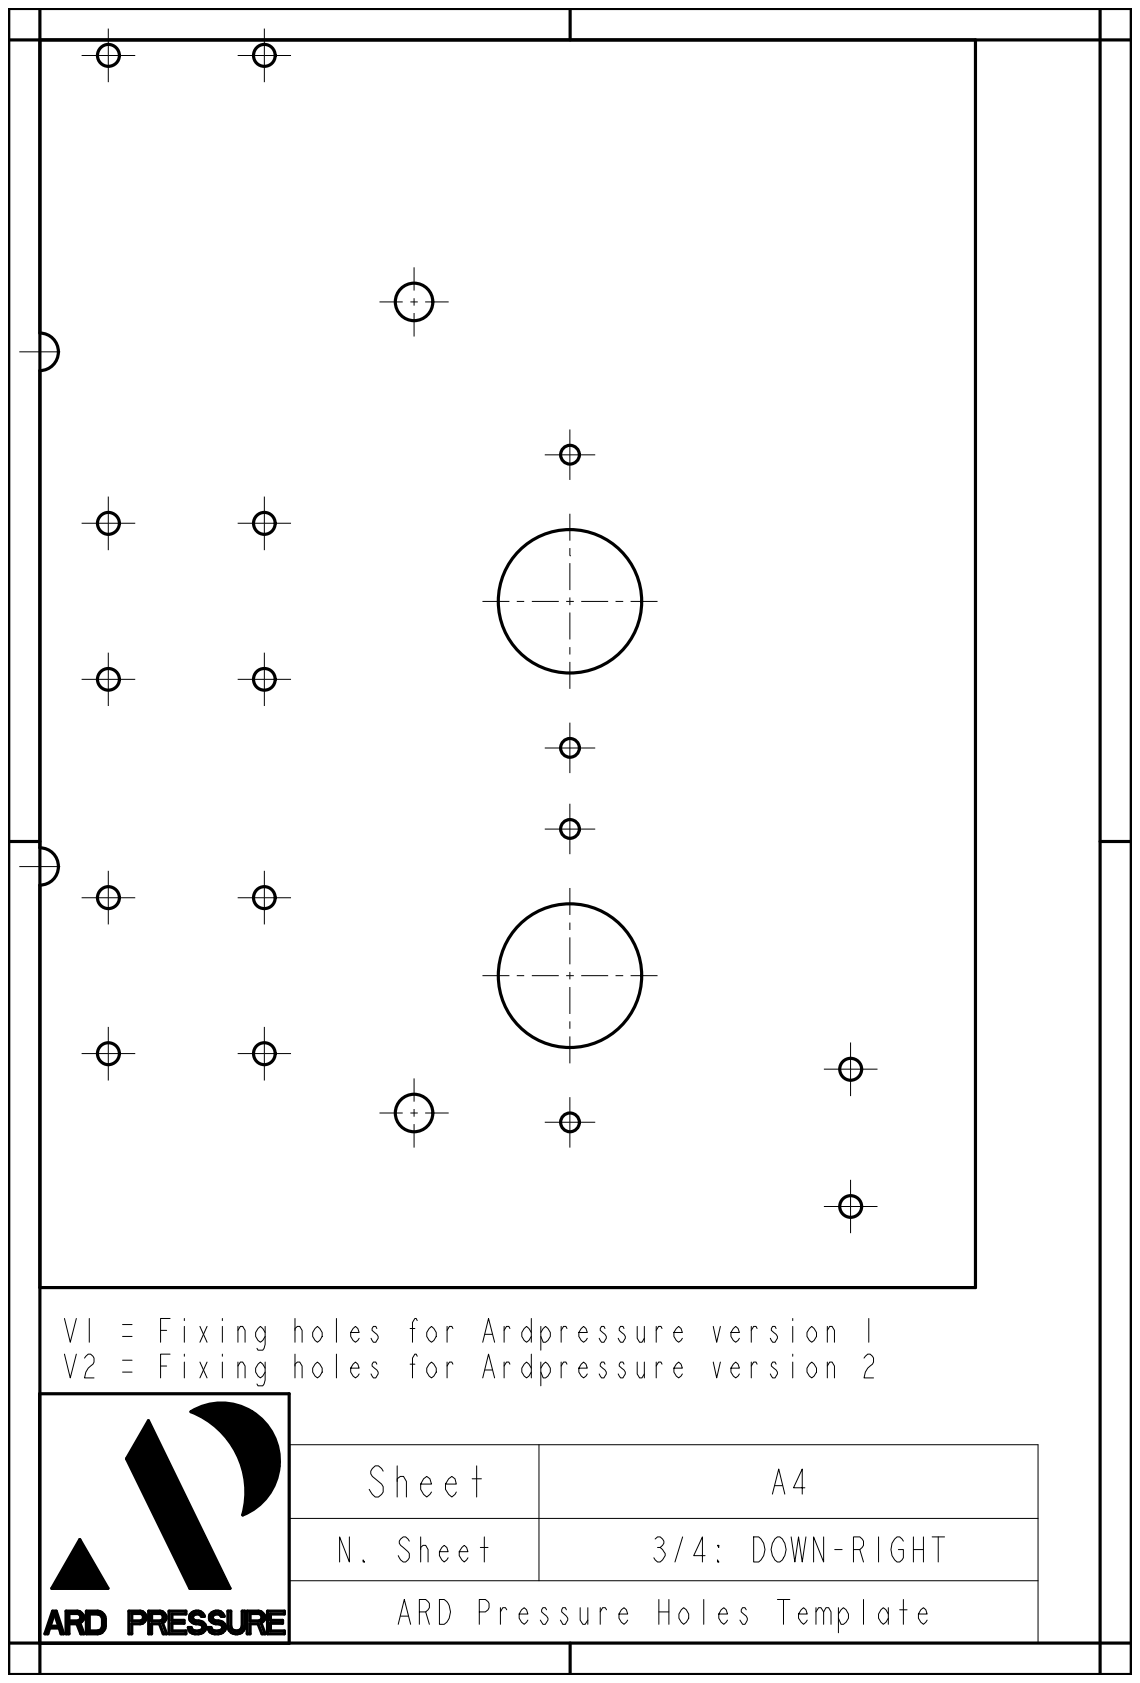
[picture p70: page 3]

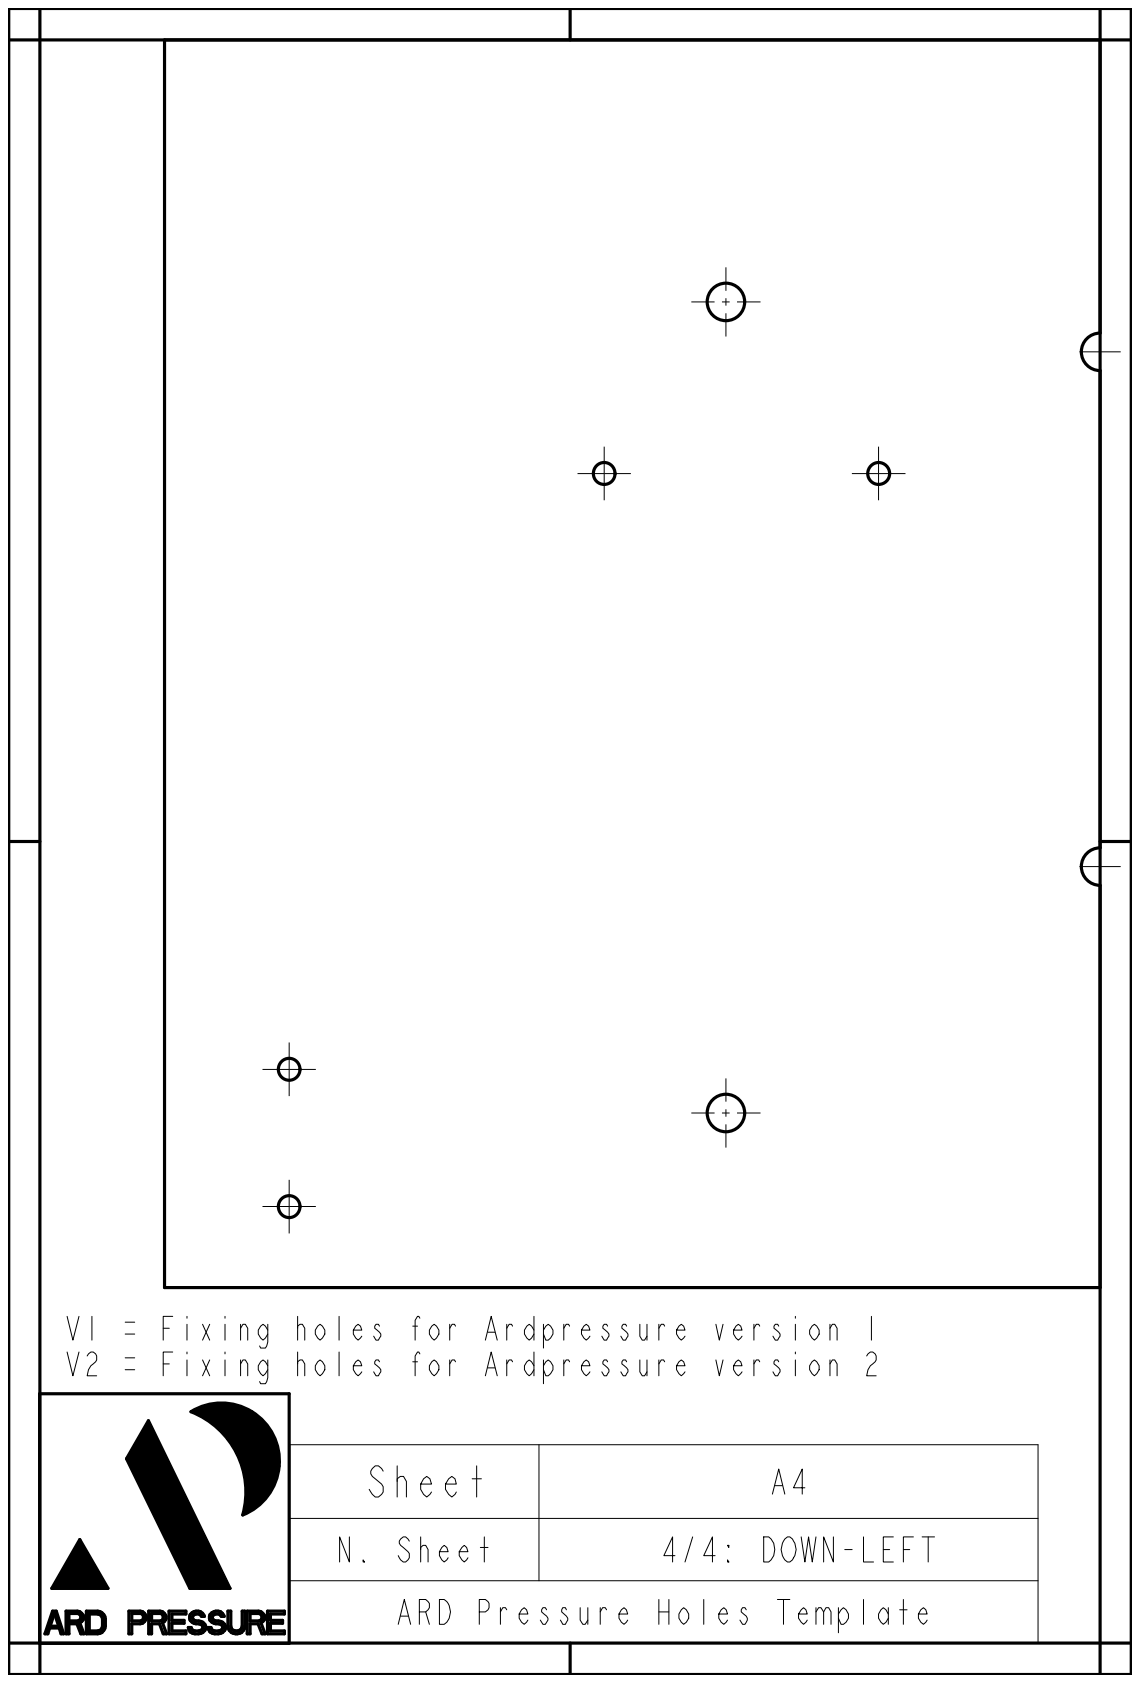
[picture p71: page 4]
