cherryphilip74/ArdPressure_filler/(commit log)

2020-05-03 ArdPressure Filler V1 (STL files)
2020-05-03 ArdPressure Filler V1 (holes template A4)
2020-05-03 ArdPressure Filler V1 (holes template A2)
2020-05-03 Assembly instruction
2020-05-03 ArdPressure V1 filler (BOM List)
2020-05-03 ArdPressure V1 filler (Assembly instruction)
2020-05-08 Holes Instruction for CNC machine (A2)
    [holes_CNC.dwg]
2020-05-19 ArdPressure Filler V1 (holes template A4) UPDATED!!
2020-05-19 ArdPressure Filler V1 (holes template A2) UPDATED!!
2020-06-05 ArdPressure Filler V1 (STL files) update
2020-06-19 ArdPressure Filler V1 (holes template A4) Final!!
